sakshar/4-bit_PC/block.pdf

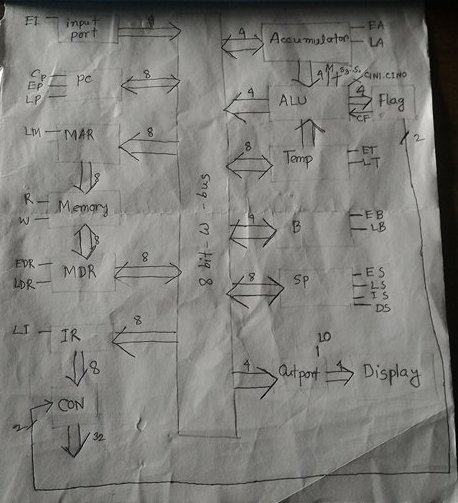
[picture p8: page 1]
