sakshar/4-bit_PC/SAP.xlsx

Macro-Instruction | Op-Code | Description | Total T-States | T-State | Micro-Operation | Active | HLT | AS1 | AS0 | LF_BAR | M | S3 | S2 | S1 | S0 | CIN1 | CIN0 | EF_BAR | EU_BAR | LS | IS | DS | ES_BAR | LT_BAR | ET_BAR | LO_BAR | EB_BAR | LB_BAR | EA_BAR | LA_BAR | EIN_BAR | LIR_BAR | MEM_BUS | LDR_BAR | EDR_BAR | EDB_BAR | W_BAR | R_BAR | LM_BAR | EM_BAR | CLEAR | CP | EP_BAR | LP | LOAD | RESET
ALL | - | Fetch | 4 | T1 | MAR ← PC | LM_BAR, EP_BAR, EM_BAR
 |  |  |  | T2 | PC← PC+1, MDR ← RAM[MAR] | CP, LDR_BAR, R_BAR, EM_BAR
 |  |  |  | T3 | IR ← MDR | EDB_BAR, LIR_BAR
 |  |  |  | T4 | LOAD from IR | LOAD
LDA address | 00H | ACC ← RAM[address] | 9 | T5 | MAR ← PC | LM_BAR, EP_BAR, EM_BAR
 |  |  |  | T6 | PC← PC+1, MDR ← RAM[MAR] | CP, LDR_BAR, R_BAR, EM_BAR
 |  |  |  | T7 | MAR ← MDR | LM_BAR, EDB_BAR, EM_BAR
 |  |  |  | T8 | MDR ← RAM[MAR] | LDR_BAR, R_BAR, EM_BAR
 |  |  |  | T9 | ACC ← MDR | LA_BAR, EDB_BAR, AS0, AS1, RESET
HALT | 0FH | Halts execution | 5 | T5 | HALT | HLT
IN | 02H | ACC ← input_port | 5 | T5 | ACC ← input_port | LA_BAR, AS0, AS1, EIN_BAR, RESET
STA address | 01H | RAM[address] ← ACC | 12 | T5 | MAR ← PC | LM_BAR, EP_BAR, EM_BAR
 |  |  |  | T6 | PC← PC+1, MDR ← RAM[MAR] | CP, LDR_BAR, R_BAR, EM_BAR
 |  |  |  | T7 | MAR ← MDR | LM_BAR, EDB_BAR, EM_BAR
 |  |  |  | T8 | MDR ← ACC | LDR_BAR, EA_BAR, MEM_BUS, EM_BAR
 |  |  |  | T9 | RAM[MAR] ← MDR | EDR_BAR, EM_BAR
 |  |  |  | T10 |  | W_BAR, EDR_BAR, EM_BAR
 |  |  |  | T11 |  | EDR_BAR, EM_BAR
 |  |  |  | T12 |  | R_BAR, RESET, EM_BAR
OUT | 03H | output_port ← ACC | 5 | T5 | output_port ← ACC | LO_BAR, EA_BAR, RESET
MOV B, ACC | 04H | B ← ACC | 5 | T5 | B ← ACC | LB_BAR, EA_BAR, RESET
MOV ACC, B | 05H | ACC ← B | 5 | T5 | ACC ← B | LA_BAR, AS0, AS1, EB_BAR, RESET
MOV ACC, immediate | 06H | ACC ← immediate | 7 | T5 | MAR ← PC | LM_BAR, EP_BAR, EM_BAR
 |  |  |  | T6 | PC← PC+1, MDR ← RAM[MAR] | CP, LDR_BAR, R_BAR, EM_BAR
 |  |  |  | T7 | ACC ← MDR | LA_BAR, AS0, AS1, EDB_BAR, RESET
NOP | 07H | NOP | 5 | T5 | NOP | RESET
JMP address | 08H | Jump to the address | 8 | T5 | MAR ← PC | LM_BAR, EP_BAR, EM_BAR
 |  |  |  | T6 | PC← PC+1, MDR ← RAM[MAR] | CP, LDR_BAR, R_BAR, EM_BAR
 |  |  |  | T7 | PC ← MDR | LP, EDB_BAR
 |  |  |  | T8 |  | CP, LP, RESET
ADD B | 09H | ACC ← ACC + B | 7 | T5 | TEMP ← B | LT_BAR, EB_BAR, S3, S0
 |  |  |  | T6 | ACC ← ACC + TEMP | S3, S0
 |  |  |  | T7 |  | LA_BAR, AS0, AS1, EU_BAR, S3, S0, LF_BAR, RESET
ADC B | 0AH | ACC ← ACC + B + C | 7 | T5 | TEMP ← B | LT_BAR, EB_BAR, S3, S0, CIN0
 |  |  |  | T6 | ACC ← ACC + TEMP + C | S3, S0, CIN0
 |  |  |  | T7 |  | LA_BAR, AS0, AS1, EU_BAR, S3, S0, CIN0, LF_BAR, RESET
SUB B | 0BH | ACC ← ACC - B | 7 | T5 | TEMP ← B | LT_BAR, EB_BAR, S2, S1, CIN1
 |  |  |  | T6 | ACC ← ACC - TEMP | S2, S1, CIN1
 |  |  |  | T7 |  | LA_BAR, AS0, AS1, EU_BAR, S2, S1, CIN1, LF_BAR, RESET
SBB B | 0CH | ACC ← ACC - B - BO | 7 | T5 | TEMP ← B | LT_BAR, EB_BAR, S2, S1, CIN1, CIN0
 |  |  |  | T6 | ACC ← ACC - TEMP - BO | S2, S1, CIN1, CIN0
 |  |  |  | T7 |  | LA_BAR, AS0, AS1, EU_BAR, S2, S1, CIN1, CIN0, LF_BAR, RESET
ADD immediate | 0DH | ACC ← ACC + immediate | 9 | T5 | MAR ← PC | LM_BAR, EP_BAR, EM_BAR
 |  |  |  | T6 | PC← PC+1, MDR ← RAM[MAR] | CP, LDR_BAR, R_BAR, EM_BAR
 |  |  |  | T7 | TEMP ← MDR | LT_BAR, EDB_BAR, S3, S0
 |  |  |  | T8 | ACC ← ACC + TEMP | S3, S0
 |  |  |  | T9 |  | LA_BAR, AS0, AS1, EU_BAR, S3, S0, LF_BAR, RESET
SUB [address] | 0EH | ACC ← ACC - RAM[address] | 11 | T5 | MAR ← PC | LM_BAR, EP_BAR, EM_BAR
 |  |  |  | T6 | PC← PC+1, MDR ← RAM[MAR] | CP, LDR_BAR, R_BAR, EM_BAR
 |  |  |  | T7 | MAR ← MDR | LM_BAR, EDB_BAR, EM_BAR
 |  |  |  | T8 | MDR ← RAM[MAR] | LDR_BAR, R_BAR, EM_BAR
 |  |  |  | T9 | TEMP ← MDR | LT_BAR, EDB_BAR, S2, S1, CIN1
 |  |  |  | T10 | ACC ← ACC - TEMP | S2, S1, CIN1
 |  |  |  | T11 |  | LA_BAR, AS0, AS1, EU_BAR, S2, S1, CIN1, LF_BAR, RESET
CMP B | 10H | ACC - B | 7 | T5 | TEMP ← B | LT_BAR, EB_BAR, S2, S1, CIN1
 |  |  |  | T6 | ACC - TEMP | S2, S1, CIN1
 |  |  |  | T7 |  | S2, S1, CIN1, LF_BAR, RESET
TEST B | 11H | ACC & B | 6 | T5 | TEMP ← B | LT_BAR, EB_BAR
 |  |  |  | T6 | ACC & TEMP | LF_BAR, M, S3, S2, S1, RESET
AND B | 12H | ACC ← ACC & B | 6 | T5 | TEMP ← B | LT_BAR, EB_BAR
 |  |  |  | T6 | ACC ← ACC & TEMP | LA_BAR, AS0, AS1, EU_BAR, M, S3, S2, S1, RESET
XOR immediate | 13H | ACC ← ACC ⊕ immediate | 8 | T5 | MAR ← PC | LM_BAR, EP_BAR, EM_BAR
 |  |  |  | T6 | PC← PC+1, MDR ← RAM[MAR] | CP, LDR_BAR, R_BAR, EM_BAR
 |  |  |  | T7 | TEMP ← MDR | LT_BAR, EDB_BAR
 |  |  |  | T8 | ACC ← ACC ⊕ TEMP | LA_BAR, AS0, AS1, EU_BAR, M, S3, S0, RESET
PUSH | 14H | RAM[SP] ← ACC | 10 | T5 | SP ← SP - 1, MDR ← ACC | DS, LDR_BAR, EA_BAR, MEM_BUS, EM_BAR
 |  |  |  | T6 | MAR ← SP | LM_BAR, ES_BAR, EM_BAR
 |  |  |  | T7 | RAM[MAR] ← MDR | EDR_BAR, EM_BAR
 |  |  |  | T8 |  | W_BAR, EDR_BAR, EM_BAR
 |  |  |  | T9 |  | EDR_BAR, EM_BAR
 |  |  |  | T10 |  | R_BAR, RESET, EM_BAR
POP | 15H | ACC ← RAM[SP] | 7 | T5 | MAR ← SP | LM_BAR, ES_BAR, EM_BAR
 |  |  |  | T6 | MDR ← RAM[MAR] | LDR_BAR, R_BAR, EM_BAR
 |  |  |  | T7 | ACC ← MDR, SP ← SP + 1 | LA_BAR, AS0, AS1, EDB_BAR, IS, RESET
CALL address | 16H | Calls a subroutine | 14 | T5 | MAR ← PC | LM_BAR, EP_BAR, EM_BAR
 |  |  |  | T6 | PC← PC+1, MDR ← RAM[MAR] | CP, LDR_BAR, R_BAR, EM_BAR
 |  |  |  | T7 | TEMP ← MDR, SP ← SP - 1 | LT_BAR, EDB_BAR, DS
 |  |  |  | T8 | MAR ← SP | LM_BAR, ES_BAR
 |  |  |  | T9 | MDR ← PC | LDR_BAR, EP_BAR, MEM_BUS
 |  |  |  | T10 | RAM[MAR] ← MDR | EDR_BAR, EM_BAR
 |  |  |  | T11 |  | W_BAR, EDR_BAR, EM_BAR
 |  |  |  | T12 |  | EDR_BAR, EM_BAR
 |  |  |  | T13 | PC ← TEMP | LP, ET_BAR
 |  |  |  | T14 |  | CP, LP, RESET
RET | 17H | Returns from current subroutine | 8 | T5 | MAR ← SP | LM_BAR, ES_BAR
 |  |  |  | T6 | MDR ← RAM[MAR] | LDR_BAR, R_BAR, EM_BAR
 |  |  |  | T7 | PC ← MDR, SP ← SP + 1 | LP, EDB_BAR, IS
 |  |  |  | T8 |  | CP, LP, RESET
SHL | 18H | ACC ← ACC << 1 | 6 | T5 | ACC ← ACC << 1 | EA_BAR
 |  |  |  | T6 |  | LA_BAR, AS0, RESET
SHR | 19H | ACC ← ACC >> 1 | 6 | T5 | ACC ← ACC >> 1 | EA_BAR
 |  |  |  | T6 |  | LA_BAR, AS1, RESET
JC address | 1AH | Jump if carry | 8 | T5 | MAR ← PC | LM_BAR, EP_BAR, EM_BAR
 |  |  |  | T6 | PC← PC+1, MDR ← RAM[MAR] | CP, LDR_BAR, R_BAR, EM_BAR
 |  |  |  | T7 | PC ← MDR | LP, EDB_BAR
 |  |  |  | T8 |  | CP, LP, RESET
JE address | 1BH | Jump if equal | 8 | T5 | MAR ← PC | LM_BAR, EP_BAR, EM_BAR
 |  |  |  | T6 | PC← PC+1, MDR ← RAM[MAR] | CP, LDR_BAR, R_BAR, EM_BAR
 |  |  |  | T7 | PC ← MDR | LP, EDB_BAR
 |  |  |  | T8 |  | CP, LP, RESET
