sakshar/4-bit_PC/Sap_MOTAMUTI_FINAL.xlsx

Sheet: BINARY
Macro-Instruction | Op-Code | Description | Total T-States | T-State | Micro-Operation | Active | HLT | AS1 | AS0 | LF_BAR | M | S3 | S2 | S1 | S0 | CIN1 | CIN0 | EF_BAR | EU_BAR | LS | IS | DS | ES_BAR | LT_BAR | ET_BAR | LO_BAR | EB_BAR | LB_BAR | EA_BAR | LA_BAR | EIN_BAR | LIR_BAR | MEM_BUS | LDR_BAR | EDR_BAR | EDB_BAR | W_BAR | R_BAR | LM_BAR | EM_BAR | CLEAR | CP | EP_BAR | LP | LOAD | RESET
ALL | - | Fetch | 4 | T1 | MAR ← PC | LM_BAR, EP_BAR, EM_BAR | 0 | 0 | 0 | 1 | 0 | 0 | 0 | 0 | 0 | 0 | 0 | 1 | 1 | 0 | 0 | 0 | 1 | 1 | 1 | 1 | 1 | 1 | 1 | 1 | 1 | 1 | 0 | 1 | 1 | 1 | 1 | 1 | 0 | 0 | 0 | 0 | 0 | 0 | 0 | 0
 |  |  |  | T2 | PC← PC+1, MDR ← RAM[MAR] | CP, LDR_BAR, R_BAR, EM_BAR | 0 | 0 | 0 | 1 | 0 | 0 | 0 | 0 | 0 | 0 | 0 | 1 | 1 | 0 | 0 | 0 | 1 | 1 | 1 | 1 | 1 | 1 | 1 | 1 | 1 | 1 | 0 | 0 | 1 | 1 | 1 | 0 | 1 | 0 | 0 | 1 | 1 | 0 | 0 | 0
 |  |  |  | T3 | IR ← MDR | EDB_BAR, LIR_BAR | 0 | 0 | 0 | 1 | 0 | 0 | 0 | 0 | 0 | 0 | 0 | 1 | 1 | 0 | 0 | 0 | 1 | 1 | 1 | 1 | 1 | 1 | 1 | 1 | 1 | 0 | 0 | 1 | 1 | 0 | 1 | 1 | 1 | 1 | 0 | 0 | 1 | 0 | 0 | 0
 |  |  |  | T4 | LOAD from IR | LOAD | 0 | 0 | 0 | 1 | 0 | 0 | 0 | 0 | 0 | 0 | 0 | 1 | 1 | 0 | 0 | 0 | 1 | 1 | 1 | 1 | 1 | 1 | 1 | 1 | 1 | 1 | 0 | 1 | 1 | 1 | 1 | 1 | 1 | 1 | 0 | 0 | 1 | 0 | 1 | 0
LDA address | 00H | ACC ← RAM[address] | 9 | T5 | MAR ← PC | LM_BAR, EP_BAR, EM_BAR | 0 | 0 | 0 | 1 | 0 | 0 | 0 | 0 | 0 | 0 | 0 | 1 | 1 | 0 | 0 | 0 | 1 | 1 | 1 | 1 | 1 | 1 | 1 | 1 | 1 | 1 | 0 | 1 | 1 | 1 | 1 | 1 | 0 | 0 | 0 | 0 | 0 | 0 | 0 | 0
 |  |  |  | T6 | PC← PC+1, MDR ← RAM[MAR] | CP, LDR_BAR, R_BAR, EM_BAR | 0 | 0 | 0 | 1 | 0 | 0 | 0 | 0 | 0 | 0 | 0 | 1 | 1 | 0 | 0 | 0 | 1 | 1 | 1 | 1 | 1 | 1 | 1 | 1 | 1 | 1 | 0 | 0 | 1 | 1 | 1 | 0 | 1 | 0 | 0 | 1 | 1 | 0 | 0 | 0
 |  |  |  | T7 | MAR ← MDR | LM_BAR, EDB_BAR, EM_BAR | 0 | 0 | 0 | 1 | 0 | 0 | 0 | 0 | 0 | 0 | 0 | 1 | 1 | 0 | 0 | 0 | 1 | 1 | 1 | 1 | 1 | 1 | 1 | 1 | 1 | 1 | 0 | 1 | 1 | 0 | 1 | 1 | 0 | 0 | 0 | 0 | 1 | 0 | 0 | 0
 |  |  |  | T8 | MDR ← RAM[MAR] | LDR_BAR, R_BAR, EM_BAR | 0 | 0 | 0 | 1 | 0 | 0 | 0 | 0 | 0 | 0 | 0 | 1 | 1 | 0 | 0 | 0 | 1 | 1 | 1 | 1 | 1 | 1 | 1 | 1 | 1 | 1 | 0 | 0 | 1 | 1 | 1 | 0 | 1 | 0 | 0 | 0 | 1 | 0 | 0 | 0
 |  |  |  | T9 | ACC ← MDR | LA_BAR, EDB_BAR, AS0, AS1, RESET | 0 | 1 | 1 | 1 | 0 | 0 | 0 | 0 | 0 | 0 | 0 | 1 | 1 | 0 | 0 | 0 | 1 | 1 | 1 | 1 | 1 | 1 | 1 | 0 | 1 | 1 | 0 | 1 | 1 | 0 | 1 | 1 | 1 | 1 | 0 | 0 | 1 | 0 | 0 | 1
HALT | 0FH | Halts execution | 5 | T5 | HALT | HLT | 1 | 0 | 0 | 1 | 0 | 0 | 0 | 0 | 0 | 0 | 0 | 1 | 1 | 0 | 0 | 0 | 1 | 1 | 1 | 1 | 1 | 1 | 1 | 1 | 1 | 1 | 0 | 1 | 1 | 1 | 1 | 1 | 1 | 1 | 0 | 0 | 1 | 0 | 0 | 0
IN | 02H | ACC ← input_port | 5 | T5 | ACC ← input_port | LA_BAR, AS0, AS1, EIN_BAR, RESET | 0 | 1 | 1 | 1 | 0 | 0 | 0 | 0 | 0 | 0 | 0 | 1 | 1 | 0 | 0 | 0 | 1 | 1 | 1 | 1 | 1 | 1 | 1 | 0 | 0 | 1 | 0 | 1 | 1 | 1 | 1 | 1 | 1 | 1 | 0 | 0 | 1 | 0 | 0 | 1
STA address | 01H | RAM[address] ← ACC | 12 | T5 | MAR ← PC | LM_BAR, EP_BAR, EM_BAR | 0 | 0 | 0 | 1 | 0 | 0 | 0 | 0 | 0 | 0 | 0 | 1 | 1 | 0 | 0 | 0 | 1 | 1 | 1 | 1 | 1 | 1 | 1 | 1 | 1 | 1 | 0 | 1 | 1 | 1 | 1 | 1 | 0 | 0 | 0 | 0 | 0 | 0 | 0 | 0
 |  |  |  | T6 | PC← PC+1, MDR ← RAM[MAR] | CP, LDR_BAR, R_BAR, EM_BAR | 0 | 0 | 0 | 1 | 0 | 0 | 0 | 0 | 0 | 0 | 0 | 1 | 1 | 0 | 0 | 0 | 1 | 1 | 1 | 1 | 1 | 1 | 1 | 1 | 1 | 1 | 0 | 0 | 1 | 1 | 1 | 0 | 1 | 0 | 0 | 1 | 1 | 0 | 0 | 0
 |  |  |  | T7 | MAR ← MDR | LM_BAR, EDB_BAR, EM_BAR | 0 | 0 | 0 | 1 | 0 | 0 | 0 | 0 | 0 | 0 | 0 | 1 | 1 | 0 | 0 | 0 | 1 | 1 | 1 | 1 | 1 | 1 | 1 | 1 | 1 | 1 | 0 | 1 | 1 | 0 | 1 | 1 | 0 | 0 | 0 | 0 | 1 | 0 | 0 | 0
 |  |  |  | T8 | MDR ← ACC | LDR_BAR, EA_BAR, MEM_BUS, EM_BAR | 0 | 0 | 0 | 1 | 0 | 0 | 0 | 0 | 0 | 0 | 0 | 1 | 1 | 0 | 0 | 0 | 1 | 1 | 1 | 1 | 1 | 1 | 0 | 1 | 1 | 1 | 1 | 0 | 1 | 1 | 1 | 1 | 1 | 0 | 0 | 0 | 1 | 0 | 0 | 0
 |  |  |  | T9 | RAM[MAR] ← MDR | EDR_BAR, EM_BAR | 0 | 0 | 0 | 1 | 0 | 0 | 0 | 0 | 0 | 0 | 0 | 1 | 1 | 0 | 0 | 0 | 1 | 1 | 1 | 1 | 1 | 1 | 1 | 1 | 1 | 1 | 0 | 1 | 0 | 1 | 1 | 1 | 1 | 0 | 0 | 0 | 1 | 0 | 0 | 0
 |  |  |  | T10 |  | W_BAR, EDR_BAR, EM_BAR | 0 | 0 | 0 | 1 | 0 | 0 | 0 | 0 | 0 | 0 | 0 | 1 | 1 | 0 | 0 | 0 | 1 | 1 | 1 | 1 | 1 | 1 | 1 | 1 | 1 | 1 | 0 | 1 | 0 | 1 | 0 | 1 | 1 | 0 | 0 | 0 | 1 | 0 | 0 | 0
 |  |  |  | T11 |  | EDR_BAR, EM_BAR | 0 | 0 | 0 | 1 | 0 | 0 | 0 | 0 | 0 | 0 | 0 | 1 | 1 | 0 | 0 | 0 | 1 | 1 | 1 | 1 | 1 | 1 | 1 | 1 | 1 | 1 | 0 | 1 | 0 | 1 | 1 | 1 | 1 | 0 | 0 | 0 | 1 | 0 | 0 | 0
 |  |  |  | T12 |  | R_BAR, RESET, EM_BAR | 0 | 0 | 0 | 1 | 0 | 0 | 0 | 0 | 0 | 0 | 0 | 1 | 1 | 0 | 0 | 0 | 1 | 1 | 1 | 1 | 1 | 1 | 1 | 1 | 1 | 1 | 0 | 1 | 1 | 1 | 1 | 0 | 1 | 0 | 0 | 0 | 1 | 0 | 0 | 1
OUT | 03H | output_port ← ACC | 5 | T5 | output_port ← ACC | LO_BAR, EA_BAR, RESET | 0 | 0 | 0 | 1 | 0 | 0 | 0 | 0 | 0 | 0 | 0 | 1 | 1 | 0 | 0 | 0 | 1 | 1 | 1 | 0 | 1 | 1 | 0 | 1 | 1 | 1 | 0 | 1 | 1 | 1 | 1 | 1 | 1 | 1 | 0 | 0 | 1 | 0 | 0 | 1
MOV B, ACC | 04H | B ← ACC | 5 | T5 | B ← ACC | LB_BAR, EA_BAR, RESET | 0 | 0 | 0 | 1 | 0 | 0 | 0 | 0 | 0 | 0 | 0 | 1 | 1 | 0 | 0 | 0 | 1 | 1 | 1 | 1 | 1 | 0 | 0 | 1 | 1 | 1 | 0 | 1 | 1 | 1 | 1 | 1 | 1 | 1 | 0 | 0 | 1 | 0 | 0 | 1
MOV ACC, B | 05H | ACC ← B | 5 | T5 | ACC ← B | LA_BAR, AS0, AS1, EB_BAR, RESET | 0 | 1 | 1 | 1 | 0 | 0 | 0 | 0 | 0 | 0 | 0 | 1 | 1 | 0 | 0 | 0 | 1 | 1 | 1 | 1 | 0 | 1 | 1 | 0 | 1 | 1 | 0 | 1 | 1 | 1 | 1 | 1 | 1 | 1 | 0 | 0 | 1 | 0 | 0 | 1
MOV ACC, immediate | 06H | ACC ← immediate | 7 | T5 | MAR ← PC | LM_BAR, EP_BAR, EM_BAR | 0 | 0 | 0 | 1 | 0 | 0 | 0 | 0 | 0 | 0 | 0 | 1 | 1 | 0 | 0 | 0 | 1 | 1 | 1 | 1 | 1 | 1 | 1 | 1 | 1 | 1 | 0 | 1 | 1 | 1 | 1 | 1 | 0 | 0 | 0 | 0 | 0 | 0 | 0 | 0
 |  |  |  | T6 | PC← PC+1, MDR ← RAM[MAR] | CP, LDR_BAR, R_BAR, EM_BAR | 0 | 0 | 0 | 1 | 0 | 0 | 0 | 0 | 0 | 0 | 0 | 1 | 1 | 0 | 0 | 0 | 1 | 1 | 1 | 1 | 1 | 1 | 1 | 1 | 1 | 1 | 0 | 0 | 1 | 1 | 1 | 0 | 1 | 0 | 0 | 1 | 1 | 0 | 0 | 0
 |  |  |  | T7 | ACC ← MDR | LA_BAR, AS0, AS1, EDB_BAR, RESET | 0 | 1 | 1 | 1 | 0 | 0 | 0 | 0 | 0 | 0 | 0 | 1 | 1 | 0 | 0 | 0 | 1 | 1 | 1 | 1 | 1 | 1 | 1 | 0 | 1 | 1 | 0 | 1 | 1 | 0 | 1 | 1 | 1 | 1 | 0 | 0 | 1 | 0 | 0 | 1
NOP | 07H | NOP | 5 | T5 | NOP | RESET | 0 | 0 | 0 | 1 | 0 | 0 | 0 | 0 | 0 | 0 | 0 | 1 | 1 | 0 | 0 | 0 | 1 | 1 | 1 | 1 | 1 | 1 | 1 | 1 | 1 | 1 | 0 | 1 | 1 | 1 | 1 | 1 | 1 | 1 | 0 | 0 | 1 | 0 | 0 | 1
JMP address | 08H | Jump to the address | 8 | T5 | MAR ← PC | LM_BAR, EP_BAR, EM_BAR | 0 | 0 | 0 | 1 | 0 | 0 | 0 | 0 | 0 | 0 | 0 | 1 | 1 | 0 | 0 | 0 | 1 | 1 | 1 | 1 | 1 | 1 | 1 | 1 | 1 | 1 | 0 | 1 | 1 | 1 | 1 | 1 | 0 | 0 | 0 | 0 | 0 | 0 | 0 | 0
 |  |  |  | T6 | PC← PC+1, MDR ← RAM[MAR] | CP, LDR_BAR, R_BAR, EM_BAR | 0 | 0 | 0 | 1 | 0 | 0 | 0 | 0 | 0 | 0 | 0 | 1 | 1 | 0 | 0 | 0 | 1 | 1 | 1 | 1 | 1 | 1 | 1 | 1 | 1 | 1 | 0 | 0 | 1 | 1 | 1 | 0 | 1 | 0 | 0 | 1 | 1 | 0 | 0 | 0
 |  |  |  | T7 | PC ← MDR | LP, EDB_BAR | 0 | 0 | 0 | 1 | 0 | 0 | 0 | 0 | 0 | 0 | 0 | 1 | 1 | 0 | 0 | 0 | 1 | 1 | 1 | 1 | 1 | 1 | 1 | 1 | 1 | 1 | 0 | 1 | 1 | 0 | 1 | 1 | 1 | 1 | 0 | 0 | 1 | 1 | 0 | 0
 |  |  |  | T8 |  | CP, LP, RESET | 0 | 0 | 0 | 1 | 0 | 0 | 0 | 0 | 0 | 0 | 0 | 1 | 1 | 0 | 0 | 0 | 1 | 1 | 1 | 1 | 1 | 1 | 1 | 1 | 1 | 1 | 0 | 1 | 1 | 1 | 1 | 1 | 1 | 1 | 0 | 1 | 1 | 1 | 0 | 1
ADD B | 09H | ACC ← ACC + B | 7 | T5 | TEMP ← B | LT_BAR, EB_BAR, S3, S0 | 0 | 0 | 0 | 1 | 0 | 1 | 0 | 0 | 1 | 0 | 0 | 1 | 1 | 0 | 0 | 0 | 1 | 0 | 1 | 1 | 0 | 1 | 1 | 1 | 1 | 1 | 0 | 1 | 1 | 1 | 1 | 1 | 1 | 1 | 0 | 0 | 1 | 0 | 0 | 0
 |  |  |  | T6 | ACC ← ACC + TEMP | S3, S0 | 0 | 0 | 0 | 1 | 0 | 1 | 0 | 0 | 1 | 0 | 0 | 1 | 1 | 0 | 0 | 0 | 1 | 1 | 1 | 1 | 1 | 1 | 1 | 1 | 1 | 1 | 0 | 1 | 1 | 1 | 1 | 1 | 1 | 1 | 0 | 0 | 1 | 0 | 0 | 0
 |  |  |  | T7 |  | LA_BAR, AS0, AS1, EU_BAR, S3, S0, LF_BAR, RESET | 0 | 1 | 1 | 0 | 0 | 1 | 0 | 0 | 1 | 0 | 0 | 1 | 0 | 0 | 0 | 0 | 1 | 1 | 1 | 1 | 1 | 1 | 1 | 0 | 1 | 1 | 0 | 1 | 1 | 1 | 1 | 1 | 1 | 1 | 0 | 0 | 1 | 0 | 0 | 1
ADC B | 0AH | ACC ← ACC + B + C | 7 | T5 | TEMP ← B | LT_BAR, EB_BAR, S3, S0, CIN0 | 0 | 0 | 0 | 1 | 0 | 1 | 0 | 0 | 1 | 0 | 1 | 1 | 1 | 0 | 0 | 0 | 1 | 0 | 1 | 1 | 0 | 1 | 1 | 1 | 1 | 1 | 0 | 1 | 1 | 1 | 1 | 1 | 1 | 1 | 0 | 0 | 1 | 0 | 0 | 0
 |  |  |  | T6 | ACC ← ACC + TEMP + C | S3, S0, CIN0 | 0 | 0 | 0 | 1 | 0 | 1 | 0 | 0 | 1 | 0 | 1 | 1 | 1 | 0 | 0 | 0 | 1 | 1 | 1 | 1 | 1 | 1 | 1 | 1 | 1 | 1 | 0 | 1 | 1 | 1 | 1 | 1 | 1 | 1 | 0 | 0 | 1 | 0 | 0 | 0
 |  |  |  | T7 |  | LA_BAR, AS0, AS1, EU_BAR, S3, S0, CIN0, LF_BAR, RESET | 0 | 1 | 1 | 0 | 0 | 1 | 0 | 0 | 1 | 0 | 1 | 1 | 0 | 0 | 0 | 0 | 1 | 1 | 1 | 1 | 1 | 1 | 1 | 0 | 1 | 1 | 0 | 1 | 1 | 1 | 1 | 1 | 1 | 1 | 0 | 0 | 1 | 0 | 0 | 1
SUB B | 0BH | ACC ← ACC - B | 7 | T5 | TEMP ← B | LT_BAR, EB_BAR, S2, S1, CIN1 | 0 | 0 | 0 | 1 | 0 | 0 | 1 | 1 | 0 | 1 | 0 | 1 | 1 | 0 | 0 | 0 | 1 | 0 | 1 | 1 | 0 | 1 | 1 | 1 | 1 | 1 | 0 | 1 | 1 | 1 | 1 | 1 | 1 | 1 | 0 | 0 | 1 | 0 | 0 | 0
 |  |  |  | T6 | ACC ← ACC - TEMP | S2, S1, CIN1 | 0 | 0 | 0 | 1 | 0 | 0 | 1 | 1 | 0 | 1 | 0 | 1 | 1 | 0 | 0 | 0 | 1 | 1 | 1 | 1 | 1 | 1 | 1 | 1 | 1 | 1 | 0 | 1 | 1 | 1 | 1 | 1 | 1 | 1 | 0 | 0 | 1 | 0 | 0 | 0
 |  |  |  | T7 |  | LA_BAR, AS0, AS1, EU_BAR, S2, S1, CIN1, LF_BAR, RESET | 0 | 1 | 1 | 0 | 0 | 0 | 1 | 1 | 0 | 1 | 0 | 1 | 0 | 0 | 0 | 0 | 1 | 1 | 1 | 1 | 1 | 1 | 1 | 0 | 1 | 1 | 0 | 1 | 1 | 1 | 1 | 1 | 1 | 1 | 0 | 0 | 1 | 0 | 0 | 1
SBB B | 0CH | ACC ← ACC - B - BO | 7 | T5 | TEMP ← B | LT_BAR, EB_BAR, S2, S1, CIN1, CIN0 | 0 | 0 | 0 | 1 | 0 | 0 | 1 | 1 | 0 | 1 | 1 | 1 | 1 | 0 | 0 | 0 | 1 | 0 | 1 | 1 | 0 | 1 | 1 | 1 | 1 | 1 | 0 | 1 | 1 | 1 | 1 | 1 | 1 | 1 | 0 | 0 | 1 | 0 | 0 | 0
 |  |  |  | T6 | ACC ← ACC - TEMP - BO | S2, S1, CIN1, CIN0 | 0 | 0 | 0 | 1 | 0 | 0 | 1 | 1 | 0 | 1 | 1 | 1 | 1 | 0 | 0 | 0 | 1 | 1 | 1 | 1 | 1 | 1 | 1 | 1 | 1 | 1 | 0 | 1 | 1 | 1 | 1 | 1 | 1 | 1 | 0 | 0 | 1 | 0 | 0 | 0
 |  |  |  | T7 |  | LA_BAR, AS0, AS1, EU_BAR, S2, S1, CIN1, CIN0, LF_BAR, RESET | 0 | 1 | 1 | 0 | 0 | 0 | 1 | 1 | 0 | 1 | 1 | 1 | 0 | 0 | 0 | 0 | 1 | 1 | 1 | 1 | 1 | 1 | 1 | 0 | 1 | 1 | 0 | 1 | 1 | 1 | 1 | 1 | 1 | 1 | 0 | 0 | 1 | 0 | 0 | 1
ADD immediate | 0DH | ACC ← ACC + immediate | 9 | T5 | MAR ← PC | LM_BAR, EP_BAR, EM_BAR | 0 | 0 | 0 | 1 | 0 | 0 | 0 | 0 | 0 | 0 | 0 | 1 | 1 | 0 | 0 | 0 | 1 | 1 | 1 | 1 | 1 | 1 | 1 | 1 | 1 | 1 | 0 | 1 | 1 | 1 | 1 | 1 | 0 | 0 | 0 | 0 | 0 | 0 | 0 | 0
 |  |  |  | T6 | PC← PC+1, MDR ← RAM[MAR] | CP, LDR_BAR, R_BAR, EM_BAR | 0 | 0 | 0 | 1 | 0 | 0 | 0 | 0 | 0 | 0 | 0 | 1 | 1 | 0 | 0 | 0 | 1 | 1 | 1 | 1 | 1 | 1 | 1 | 1 | 1 | 1 | 0 | 0 | 1 | 1 | 1 | 0 | 1 | 0 | 0 | 1 | 1 | 0 | 0 | 0
 |  |  |  | T7 | TEMP ← MDR | LT_BAR, EDB_BAR, S3, S0 | 0 | 0 | 0 | 1 | 0 | 1 | 0 | 0 | 1 | 0 | 0 | 1 | 1 | 0 | 0 | 0 | 1 | 0 | 1 | 1 | 1 | 1 | 1 | 1 | 1 | 1 | 0 | 1 | 1 | 0 | 1 | 1 | 1 | 1 | 0 | 0 | 1 | 0 | 0 | 0
 |  |  |  | T8 | ACC ← ACC + TEMP | S3, S0 | 0 | 0 | 0 | 1 | 0 | 1 | 0 | 0 | 1 | 0 | 0 | 1 | 1 | 0 | 0 | 0 | 1 | 1 | 1 | 1 | 1 | 1 | 1 | 1 | 1 | 1 | 0 | 1 | 1 | 1 | 1 | 1 | 1 | 1 | 0 | 0 | 1 | 0 | 0 | 0
 |  |  |  | T9 |  | LA_BAR, AS0, AS1, EU_BAR, S3, S0, LF_BAR, RESET | 0 | 1 | 1 | 0 | 0 | 1 | 0 | 0 | 1 | 0 | 0 | 1 | 0 | 0 | 0 | 0 | 1 | 1 | 1 | 1 | 1 | 1 | 1 | 0 | 1 | 1 | 0 | 1 | 1 | 1 | 1 | 1 | 1 | 1 | 0 | 0 | 1 | 0 | 0 | 1
SUB [address] | 0EH | ACC ← ACC - RAM[address] | 11 | T5 | MAR ← PC | LM_BAR, EP_BAR, EM_BAR | 0 | 0 | 0 | 1 | 0 | 0 | 0 | 0 | 0 | 0 | 0 | 1 | 1 | 0 | 0 | 0 | 1 | 1 | 1 | 1 | 1 | 1 | 1 | 1 | 1 | 1 | 0 | 1 | 1 | 1 | 1 | 1 | 0 | 0 | 0 | 0 | 0 | 0 | 0 | 0
 |  |  |  | T6 | PC← PC+1, MDR ← RAM[MAR] | CP, LDR_BAR, R_BAR, EM_BAR | 0 | 0 | 0 | 1 | 0 | 0 | 0 | 0 | 0 | 0 | 0 | 1 | 1 | 0 | 0 | 0 | 1 | 1 | 1 | 1 | 1 | 1 | 1 | 1 | 1 | 1 | 0 | 0 | 1 | 1 | 1 | 0 | 1 | 0 | 0 | 1 | 1 | 0 | 0 | 0
 |  |  |  | T7 | MAR ← MDR | LM_BAR, EDB_BAR, EM_BAR | 0 | 0 | 0 | 1 | 0 | 0 | 0 | 0 | 0 | 0 | 0 | 1 | 1 | 0 | 0 | 0 | 1 | 1 | 1 | 1 | 1 | 1 | 1 | 1 | 1 | 1 | 0 | 1 | 1 | 0 | 1 | 1 | 0 | 0 | 0 | 0 | 1 | 0 | 0 | 0
 |  |  |  | T8 | MDR ← RAM[MAR] | LDR_BAR, R_BAR, EM_BAR | 0 | 0 | 0 | 1 | 0 | 0 | 0 | 0 | 0 | 0 | 0 | 1 | 1 | 0 | 0 | 0 | 1 | 1 | 1 | 1 | 1 | 1 | 1 | 1 | 1 | 1 | 0 | 0 | 1 | 1 | 1 | 0 | 1 | 0 | 0 | 0 | 1 | 0 | 0 | 0
 |  |  |  | T9 | TEMP ← MDR | LT_BAR, EDB_BAR, S2, S1, CIN1 | 0 | 0 | 0 | 1 | 0 | 0 | 1 | 1 | 0 | 1 | 0 | 1 | 1 | 0 | 0 | 0 | 1 | 0 | 1 | 1 | 1 | 1 | 1 | 1 | 1 | 1 | 0 | 1 | 1 | 0 | 1 | 1 | 1 | 1 | 0 | 0 | 1 | 0 | 0 | 0
 |  |  |  | T10 | ACC ← ACC - TEMP | S2, S1, CIN1 | 0 | 0 | 0 | 1 | 0 | 0 | 1 | 1 | 0 | 1 | 0 | 1 | 1 | 0 | 0 | 0 | 1 | 1 | 1 | 1 | 1 | 1 | 1 | 1 | 1 | 1 | 0 | 1 | 1 | 1 | 1 | 1 | 1 | 1 | 0 | 0 | 1 | 0 | 0 | 0
 |  |  |  | T11 |  | LA_BAR, AS0, AS1, EU_BAR, S2, S1, CIN1, LF_BAR, RESET | 0 | 1 | 1 | 0 | 0 | 0 | 1 | 1 | 0 | 1 | 0 | 1 | 0 | 0 | 0 | 0 | 1 | 1 | 1 | 1 | 1 | 1 | 1 | 0 | 1 | 1 | 0 | 1 | 1 | 1 | 1 | 1 | 1 | 1 | 0 | 0 | 1 | 0 | 0 | 1
CMP B | 10H | ACC - B | 7 | T5 | TEMP ← B | LT_BAR, EB_BAR, S2, S1, CIN1 | 0 | 0 | 0 | 1 | 0 | 0 | 1 | 1 | 0 | 1 | 0 | 1 | 1 | 0 | 0 | 0 | 1 | 0 | 1 | 1 | 0 | 1 | 1 | 1 | 1 | 1 | 0 | 1 | 1 | 1 | 1 | 1 | 1 | 1 | 0 | 0 | 1 | 0 | 0 | 0
 |  |  |  | T6 | ACC - TEMP | S2, S1, CIN1 | 0 | 0 | 0 | 1 | 0 | 0 | 1 | 1 | 0 | 1 | 0 | 1 | 1 | 0 | 0 | 0 | 1 | 1 | 1 | 1 | 1 | 1 | 1 | 1 | 1 | 1 | 0 | 1 | 1 | 1 | 1 | 1 | 1 | 1 | 0 | 0 | 1 | 0 | 0 | 0
 |  |  |  | T7 |  | S2, S1, CIN1, LF_BAR, RESET | 0 | 0 | 0 | 0 | 0 | 0 | 1 | 1 | 0 | 1 | 0 | 1 | 1 | 0 | 0 | 0 | 1 | 1 | 1 | 1 | 1 | 1 | 1 | 1 | 1 | 1 | 0 | 1 | 1 | 1 | 1 | 1 | 1 | 1 | 0 | 0 | 1 | 0 | 0 | 1
TEST B | 11H | ACC & B | 6 | T5 | TEMP ← B | LT_BAR, EB_BAR | 0 | 0 | 0 | 1 | 0 | 0 | 0 | 0 | 0 | 0 | 0 | 1 | 1 | 0 | 0 | 0 | 1 | 0 | 1 | 1 | 0 | 1 | 1 | 1 | 1 | 1 | 0 | 1 | 1 | 1 | 1 | 1 | 1 | 1 | 0 | 0 | 1 | 0 | 0 | 0
 |  |  |  | T6 | ACC & TEMP | LF_BAR, M, S3, S2, S1, RESET | 0 | 0 | 0 | 0 | 1 | 1 | 1 | 1 | 0 | 0 | 0 | 1 | 1 | 0 | 0 | 0 | 1 | 1 | 1 | 1 | 1 | 1 | 1 | 1 | 1 | 1 | 0 | 1 | 1 | 1 | 1 | 1 | 1 | 1 | 0 | 0 | 1 | 0 | 0 | 1
AND B | 12H | ACC ← ACC & B | 6 | T5 | TEMP ← B | LT_BAR, EB_BAR | 0 | 0 | 0 | 1 | 0 | 0 | 0 | 0 | 0 | 0 | 0 | 1 | 1 | 0 | 0 | 0 | 1 | 0 | 1 | 1 | 0 | 1 | 1 | 1 | 1 | 1 | 0 | 1 | 1 | 1 | 1 | 1 | 1 | 1 | 0 | 0 | 1 | 0 | 0 | 0
 |  |  |  | T6 | ACC ← ACC & TEMP | LA_BAR, AS0, AS1, EU_BAR, M, S3, S2, S1, RESET | 0 | 1 | 1 | 1 | 1 | 1 | 1 | 1 | 0 | 0 | 0 | 1 | 0 | 0 | 0 | 0 | 1 | 1 | 1 | 1 | 1 | 1 | 1 | 0 | 1 | 1 | 0 | 1 | 1 | 1 | 1 | 1 | 1 | 1 | 0 | 0 | 1 | 0 | 0 | 1
XOR immediate | 13H | ACC ← ACC ⊕ immediate | 8 | T5 | MAR ← PC | LM_BAR, EP_BAR, EM_BAR | 0 | 0 | 0 | 1 | 0 | 0 | 0 | 0 | 0 | 0 | 0 | 1 | 1 | 0 | 0 | 0 | 1 | 1 | 1 | 1 | 1 | 1 | 1 | 1 | 1 | 1 | 0 | 1 | 1 | 1 | 1 | 1 | 0 | 0 | 0 | 0 | 0 | 0 | 0 | 0
 |  |  |  | T6 | PC← PC+1, MDR ← RAM[MAR] | CP, LDR_BAR, R_BAR, EM_BAR | 0 | 0 | 0 | 1 | 0 | 0 | 0 | 0 | 0 | 0 | 0 | 1 | 1 | 0 | 0 | 0 | 1 | 1 | 1 | 1 | 1 | 1 | 1 | 1 | 1 | 1 | 0 | 0 | 1 | 1 | 1 | 0 | 1 | 0 | 0 | 1 | 1 | 0 | 0 | 0
 |  |  |  | T7 | TEMP ← MDR | LT_BAR, EDB_BAR | 0 | 0 | 0 | 1 | 0 | 0 | 0 | 0 | 0 | 0 | 0 | 1 | 1 | 0 | 0 | 0 | 1 | 0 | 1 | 1 | 1 | 1 | 1 | 1 | 1 | 1 | 0 | 1 | 1 | 0 | 1 | 1 | 1 | 1 | 0 | 0 | 1 | 0 | 0 | 0
 |  |  |  | T8 | ACC ← ACC ⊕ TEMP | LA_BAR, AS0, AS1, EU_BAR, M, S3, S0, RESET | 0 | 1 | 1 | 1 | 1 | 1 | 0 | 0 | 1 | 0 | 0 | 1 | 0 | 0 | 0 | 0 | 1 | 1 | 1 | 1 | 1 | 1 | 1 | 0 | 1 | 1 | 0 | 1 | 1 | 1 | 1 | 1 | 1 | 1 | 0 | 0 | 1 | 0 | 0 | 1
PUSH | 14H | RAM[SP] ← ACC | 10 | T5 | SP ← SP - 1, MDR ← ACC | DS, LDR_BAR, EA_BAR, MEM_BUS, EM_BAR | 0 | 0 | 0 | 1 | 0 | 0 | 0 | 0 | 0 | 0 | 0 | 1 | 1 | 0 | 0 | 1 | 1 | 1 | 1 | 1 | 1 | 1 | 0 | 1 | 1 | 1 | 1 | 0 | 1 | 1 | 1 | 1 | 1 | 0 | 0 | 0 | 1 | 0 | 0 | 0
 |  |  |  | T6 | MAR ← SP | LM_BAR, ES_BAR, EM_BAR | 0 | 0 | 0 | 1 | 0 | 0 | 0 | 0 | 0 | 0 | 0 | 1 | 1 | 0 | 0 | 0 | 0 | 1 | 1 | 1 | 1 | 1 | 1 | 1 | 1 | 1 | 0 | 1 | 1 | 1 | 1 | 1 | 0 | 0 | 0 | 0 | 1 | 0 | 0 | 0
 |  |  |  | T7 | RAM[MAR] ← MDR | EDR_BAR, EM_BAR | 0 | 0 | 0 | 1 | 0 | 0 | 0 | 0 | 0 | 0 | 0 | 1 | 1 | 0 | 0 | 0 | 1 | 1 | 1 | 1 | 1 | 1 | 1 | 1 | 1 | 1 | 0 | 1 | 0 | 1 | 1 | 1 | 1 | 0 | 0 | 0 | 1 | 0 | 0 | 0
 |  |  |  | T8 |  | W_BAR, EDR_BAR, EM_BAR | 0 | 0 | 0 | 1 | 0 | 0 | 0 | 0 | 0 | 0 | 0 | 1 | 1 | 0 | 0 | 0 | 1 | 1 | 1 | 1 | 1 | 1 | 1 | 1 | 1 | 1 | 0 | 1 | 0 | 1 | 0 | 1 | 1 | 0 | 0 | 0 | 1 | 0 | 0 | 0
 |  |  |  | T9 |  | EDR_BAR, EM_BAR | 0 | 0 | 0 | 1 | 0 | 0 | 0 | 0 | 0 | 0 | 0 | 1 | 1 | 0 | 0 | 0 | 1 | 1 | 1 | 1 | 1 | 1 | 1 | 1 | 1 | 1 | 0 | 1 | 0 | 1 | 1 | 1 | 1 | 0 | 0 | 0 | 1 | 0 | 0 | 0
 |  |  |  | T10 |  | R_BAR, RESET, EM_BAR | 0 | 0 | 0 | 1 | 0 | 0 | 0 | 0 | 0 | 0 | 0 | 1 | 1 | 0 | 0 | 0 | 1 | 1 | 1 | 1 | 1 | 1 | 1 | 1 | 1 | 1 | 0 | 1 | 1 | 1 | 1 | 0 | 1 | 0 | 0 | 0 | 1 | 0 | 0 | 1
POP | 15H | ACC ← RAM[SP] |  | T5 | MAR ← SP | LM_BAR, ES_BAR, EM_BAR | 0 | 0 | 0 | 1 | 0 | 0 | 0 | 0 | 0 | 0 | 0 | 1 | 1 | 0 | 0 | 0 | 0 | 1 | 1 | 1 | 1 | 1 | 1 | 1 | 1 | 1 | 0 | 1 | 1 | 1 | 1 | 1 | 0 | 0 | 0 | 0 | 1 | 0 | 0 | 0
 |  |  |  | T6 | MDR ← RAM[MAR] | LDR_BAR, R_BAR, EM_BAR | 0 | 0 | 0 | 1 | 0 | 0 | 0 | 0 | 0 | 0 | 0 | 1 | 1 | 0 | 0 | 0 | 1 | 1 | 1 | 1 | 1 | 1 | 1 | 1 | 1 | 1 | 0 | 0 | 1 | 1 | 1 | 0 | 1 | 0 | 0 | 0 | 1 | 0 | 0 | 0
 |  |  |  | T7 | ACC ← MDR, SP ← SP + 1 | LA_BAR, AS0, AS1, EDB_BAR, IS, RESET | 0 | 1 | 1 | 1 | 0 | 0 | 0 | 0 | 0 | 0 | 0 | 1 | 1 | 0 | 1 | 0 | 1 | 1 | 1 | 1 | 1 | 1 | 1 | 0 | 1 | 1 | 0 | 1 | 1 | 0 | 1 | 1 | 1 | 1 | 0 | 0 | 1 | 0 | 0 | 1
CALL address | 16H | Calls a subroutine | 14 | T5 | MAR ← PC | LM_BAR, EP_BAR, EM_BAR | 0 | 0 | 0 | 1 | 0 | 0 | 0 | 0 | 0 | 0 | 0 | 1 | 1 | 0 | 0 | 0 | 1 | 1 | 1 | 1 | 1 | 1 | 1 | 1 | 1 | 1 | 0 | 1 | 1 | 1 | 1 | 1 | 0 | 0 | 0 | 0 | 0 | 0 | 0 | 0
 |  |  |  | T6 | PC← PC+1, MDR ← RAM[MAR] | CP, LDR_BAR, R_BAR, EM_BAR | 0 | 0 | 0 | 1 | 0 | 0 | 0 | 0 | 0 | 0 | 0 | 1 | 1 | 0 | 0 | 0 | 1 | 1 | 1 | 1 | 1 | 1 | 1 | 1 | 1 | 1 | 0 | 0 | 1 | 1 | 1 | 0 | 1 | 0 | 0 | 1 | 1 | 0 | 0 | 0
 |  |  |  | T7 | TEMP ← MDR, SP ← SP - 1 | LT_BAR, EDB_BAR, DS | 0 | 0 | 0 | 1 | 0 | 0 | 0 | 0 | 0 | 0 | 0 | 1 | 1 | 0 | 0 | 1 | 1 | 0 | 1 | 1 | 1 | 1 | 1 | 1 | 1 | 1 | 0 | 1 | 1 | 0 | 1 | 1 | 1 | 1 | 0 | 0 | 1 | 0 | 0 | 0
 |  |  |  | T8 | MAR ← SP | LM_BAR, ES_BAR | 0 | 0 | 0 | 1 | 0 | 0 | 0 | 0 | 0 | 0 | 0 | 1 | 1 | 0 | 0 | 0 | 0 | 1 | 1 | 1 | 1 | 1 | 1 | 1 | 1 | 1 | 0 | 1 | 1 | 1 | 1 | 1 | 0 | 1 | 0 | 0 | 1 | 0 | 0 | 0
 |  |  |  | T9 | MDR ← PC | LDR_BAR, EP_BAR, MEM_BUS | 0 | 0 | 0 | 1 | 0 | 0 | 0 | 0 | 0 | 0 | 0 | 1 | 1 | 0 | 0 | 0 | 1 | 1 | 1 | 1 | 1 | 1 | 1 | 1 | 1 | 1 | 1 | 0 | 1 | 1 | 1 | 1 | 1 | 1 | 0 | 0 | 0 | 0 | 0 | 0
 |  |  |  | T10 | RAM[MAR] ← MDR | EDR_BAR, EM_BAR | 0 | 0 | 0 | 1 | 0 | 0 | 0 | 0 | 0 | 0 | 0 | 1 | 1 | 0 | 0 | 0 | 1 | 1 | 1 | 1 | 1 | 1 | 1 | 1 | 1 | 1 | 0 | 1 | 0 | 1 | 1 | 1 | 1 | 0 | 0 | 0 | 1 | 0 | 0 | 0
 |  |  |  | T11 |  | W_BAR, EDR_BAR, EM_BAR | 0 | 0 | 0 | 1 | 0 | 0 | 0 | 0 | 0 | 0 | 0 | 1 | 1 | 0 | 0 | 0 | 1 | 1 | 1 | 1 | 1 | 1 | 1 | 1 | 1 | 1 | 0 | 1 | 0 | 1 | 0 | 1 | 1 | 0 | 0 | 0 | 1 | 0 | 0 | 0
 |  |  |  | T12 |  | EDR_BAR, EM_BAR | 0 | 0 | 0 | 1 | 0 | 0 | 0 | 0 | 0 | 0 | 0 | 1 | 1 | 0 | 0 | 0 | 1 | 1 | 1 | 1 | 1 | 1 | 1 | 1 | 1 | 1 | 0 | 1 | 0 | 1 | 1 | 1 | 1 | 0 | 0 | 0 | 1 | 0 | 0 | 0
 |  |  |  | T13 | PC ← TEMP | LP, ET_BAR | 0 | 0 | 0 | 1 | 0 | 0 | 0 | 0 | 0 | 0 | 0 | 1 | 1 | 0 | 0 | 0 | 1 | 1 | 0 | 1 | 1 | 1 | 1 | 1 | 1 | 1 | 0 | 1 | 1 | 1 | 1 | 1 | 1 | 1 | 0 | 0 | 1 | 1 | 0 | 0
 |  |  |  | T14 |  | CP, LP, RESET | 0 | 0 | 0 | 1 | 0 | 0 | 0 | 0 | 0 | 0 | 0 | 1 | 1 | 0 | 0 | 0 | 1 | 1 | 1 | 1 | 1 | 1 | 1 | 1 | 1 | 1 | 0 | 1 | 1 | 1 | 1 | 1 | 1 | 1 | 0 | 1 | 1 | 1 | 0 | 1
RET | 17H | Returns from current subroutine | 8 | T5 | MAR ← SP | LM_BAR, ES_BAR | 0 | 0 | 0 | 1 | 0 | 0 | 0 | 0 | 0 | 0 | 0 | 1 | 1 | 0 | 0 | 0 | 0 | 1 | 1 | 1 | 1 | 1 | 1 | 1 | 1 | 1 | 0 | 1 | 1 | 1 | 1 | 1 | 0 | 1 | 0 | 0 | 1 | 0 | 0 | 0
 |  |  |  | T6 | MDR ← RAM[MAR] | LDR_BAR, R_BAR, EM_BAR | 0 | 0 | 0 | 1 | 0 | 0 | 0 | 0 | 0 | 0 | 0 | 1 | 1 | 0 | 0 | 0 | 1 | 1 | 1 | 1 | 1 | 1 | 1 | 1 | 1 | 1 | 0 | 0 | 1 | 1 | 1 | 0 | 1 | 0 | 0 | 0 | 1 | 0 | 0 | 0
 |  |  |  | T7 | PC ← MDR, SP ← SP + 1 | LP, EDB_BAR, IS | 0 | 0 | 0 | 1 | 0 | 0 | 0 | 0 | 0 | 0 | 0 | 1 | 1 | 0 | 1 | 0 | 1 | 1 | 1 | 1 | 1 | 1 | 1 | 1 | 1 | 1 | 0 | 1 | 1 | 0 | 1 | 1 | 1 | 1 | 0 | 0 | 1 | 1 | 0 | 0
 |  |  |  | T8 |  | CP, LP, RESET | 0 | 0 | 0 | 1 | 0 | 0 | 0 | 0 | 0 | 0 | 0 | 1 | 1 | 0 | 0 | 0 | 1 | 1 | 1 | 1 | 1 | 1 | 1 | 1 | 1 | 1 | 0 | 1 | 1 | 1 | 1 | 1 | 1 | 1 | 0 | 1 | 1 | 1 | 0 | 1
SHL | 18H | ACC ← ACC << 1 | 6 | T5 | ACC ← ACC << 1 | EA_BAR | 0 | 0 | 0 | 1 | 0 | 0 | 0 | 0 | 0 | 0 | 0 | 1 | 1 | 0 | 0 | 0 | 1 | 1 | 1 | 1 | 1 | 1 | 0 | 1 | 1 | 1 | 0 | 1 | 1 | 1 | 1 | 1 | 1 | 1 | 0 | 0 | 1 | 0 | 0 | 0
 |  |  |  | T6 |  | LA_BAR, AS0, RESET | 0 | 1 | 0 | 1 | 0 | 0 | 0 | 0 | 0 | 0 | 0 | 1 | 1 | 0 | 0 | 0 | 1 | 1 | 1 | 1 | 1 | 1 | 0 | 0 | 1 | 1 | 0 | 1 | 1 | 1 | 1 | 1 | 1 | 1 | 0 | 0 | 1 | 0 | 0 | 1
SHR | 19H | ACC ← ACC >> 1 | 6 | T5 | ACC ← ACC >> 1 | EA_BAR | 0 | 0 | 0 | 1 | 0 | 0 | 0 | 0 | 0 | 0 | 0 | 1 | 1 | 0 | 0 | 0 | 1 | 1 | 1 | 1 | 1 | 1 | 0 | 1 | 1 | 1 | 0 | 1 | 1 | 1 | 1 | 1 | 1 | 1 | 0 | 0 | 1 | 0 | 0 | 0
 |  |  |  | T6 |  | LA_BAR, AS1, RESET | 0 | 0 | 1 | 1 | 0 | 0 | 0 | 0 | 0 | 0 | 0 | 1 | 1 | 0 | 0 | 0 | 1 | 1 | 1 | 1 | 1 | 1 | 0 | 0 | 1 | 1 | 0 | 1 | 1 | 1 | 1 | 1 | 1 | 1 | 0 | 0 | 1 | 0 | 0 | 1
JC address | 3AH | Jump if carry | 8 | T5 | MAR ← PC | LM_BAR, EP_BAR, EM_BAR | 0 | 0 | 0 | 1 | 0 | 0 | 0 | 0 | 0 | 0 | 0 | 1 | 1 | 0 | 0 | 0 | 1 | 1 | 1 | 1 | 1 | 1 | 1 | 1 | 1 | 1 | 0 | 1 | 1 | 1 | 1 | 1 | 0 | 0 | 0 | 0 | 0 | 0 | 0 | 0
 |  |  |  | T6 | PC← PC+1, MDR ← RAM[MAR] | CP, LDR_BAR, R_BAR, EM_BAR | 0 | 0 | 0 | 1 | 0 | 0 | 0 | 0 | 0 | 0 | 0 | 1 | 1 | 0 | 0 | 0 | 1 | 1 | 1 | 1 | 1 | 1 | 1 | 1 | 1 | 1 | 0 | 0 | 1 | 1 | 1 | 0 | 1 | 0 | 0 | 1 | 1 | 0 | 0 | 0
 |  |  |  | T7 | PC ← MDR | LP, EDB_BAR | 0 | 0 | 0 | 1 | 0 | 0 | 0 | 0 | 0 | 0 | 0 | 1 | 1 | 0 | 0 | 0 | 1 | 1 | 1 | 1 | 1 | 1 | 1 | 1 | 1 | 1 | 0 | 1 | 1 | 0 | 1 | 1 | 1 | 1 | 0 | 0 | 1 | 1 | 0 | 0
 |  |  |  | T8 |  | CP, LP, RESET | 0 | 0 | 0 | 1 | 0 | 0 | 0 | 0 | 0 | 0 | 0 | 1 | 1 | 0 | 0 | 0 | 1 | 1 | 1 | 1 | 1 | 1 | 1 | 1 | 1 | 1 | 0 | 1 | 1 | 1 | 1 | 1 | 1 | 1 | 0 | 1 | 1 | 1 | 0 | 1
JE address | 5BH | Jump if equal | 8 | T5 | MAR ← PC | LM_BAR, EP_BAR, EM_BAR | 0 | 0 | 0 | 1 | 0 | 0 | 0 | 0 | 0 | 0 | 0 | 1 | 1 | 0 | 0 | 0 | 1 | 1 | 1 | 1 | 1 | 1 | 1 | 1 | 1 | 1 | 0 | 1 | 1 | 1 | 1 | 1 | 0 | 0 | 0 | 0 | 0 | 0 | 0 | 0
 |  |  |  | T6 | PC← PC+1, MDR ← RAM[MAR] | CP, LDR_BAR, R_BAR, EM_BAR | 0 | 0 | 0 | 1 | 0 | 0 | 0 | 0 | 0 | 0 | 0 | 1 | 1 | 0 | 0 | 0 | 1 | 1 | 1 | 1 | 1 | 1 | 1 | 1 | 1 | 1 | 0 | 0 | 1 | 1 | 1 | 0 | 1 | 0 | 0 | 1 | 1 | 0 | 0 | 0
 |  |  |  | T7 | PC ← MDR | LP, EDB_BAR | 0 | 0 | 0 | 1 | 0 | 0 | 0 | 0 | 0 | 0 | 0 | 1 | 1 | 0 | 0 | 0 | 1 | 1 | 1 | 1 | 1 | 1 | 1 | 1 | 1 | 1 | 0 | 1 | 1 | 0 | 1 | 1 | 1 | 1 | 0 | 0 | 1 | 1 | 0 | 0
 |  |  |  | T8 |  | CP, LP, RESET | 0 | 0 | 0 | 1 | 0 | 0 | 0 | 0 | 0 | 0 | 0 | 1 | 1 | 0 | 0 | 0 | 1 | 1 | 1 | 1 | 1 | 1 | 1 | 1 | 1 | 1 | 0 | 1 | 1 | 1 | 1 | 1 | 1 | 1 | 0 | 1 | 1 | 1 | 0 | 1
if not jump | 1AH, 1BH |  | 5 | T5 | PC← PC+1 | CP, RESET | 0 | 0 | 0 | 1 | 0 | 0 | 0 | 0 | 0 | 0 | 0 | 1 | 1 | 0 | 0 | 0 | 1 | 1 | 1 | 1 | 1 | 1 | 1 | 1 | 1 | 1 | 0 | 1 | 1 | 1 | 1 | 1 | 1 | 1 | 0 | 1 | 1 | 0 | 0 | 1

Sheet: HEX
Macro-Instruction | Op-Code | Description | Total T-States | T-State | Micro-Operation | Active | CROM0 | CROM1 | CROM2 | CROM3 | CROM4
ALL | - | Fetch | 4 | T1 | MAR ← PC | LM_BAR, EP_BAR, EM_BAR | 10 | 18 | ff | df | 0
 |  |  |  | T2 | PC← PC+1, MDR ← RAM[MAR] | CP, LDR_BAR, R_BAR, EM_BAR | 10 | 18 | ff | ce | 98
 |  |  |  | T3 | IR ← MDR | EDB_BAR, LIR_BAR | 10 | 18 | ff | 9b | c8
 |  |  |  | T4 | LOAD from IR | LOAD | 10 | 18 | ff | df | ca
LDA address | 00H | ACC ← RAM[address] | 9 | T5 | MAR ← PC | LM_BAR, EP_BAR, EM_BAR | 10 | 18 | ff | df | 0
 |  |  |  | T6 | PC← PC+1, MDR ← RAM[MAR] | CP, LDR_BAR, R_BAR, EM_BAR | 10 | 18 | ff | ce | 98
 |  |  |  | T7 | MAR ← MDR | LM_BAR, EDB_BAR, EM_BAR | 10 | 18 | ff | db | 8
 |  |  |  | T8 | MDR ← RAM[MAR] | LDR_BAR, R_BAR, EM_BAR | 10 | 18 | ff | ce | 88
 |  |  |  | T9 | ACC ← MDR | LA_BAR, EDB_BAR, AS0, AS1, RESET | 70 | 18 | fe | db | c9
HALT | 0FH | Halts execution | 5 | T5 | HALT | HLT | 90 | 18 | ff | df | c8
IN | 02H | ACC ← input_port | 5 | T5 | ACC ← input_port | LA_BAR, AS0, AS1, EIN_BAR, RESET | 70 | 18 | fe | 5f | c9
STA address | 01H | RAM[address] ← ACC | 12 | T5 | MAR ← PC | LM_BAR, EP_BAR, EM_BAR | 10 | 18 | ff | df | 0
 |  |  |  | T6 | PC← PC+1, MDR ← RAM[MAR] | CP, LDR_BAR, R_BAR, EM_BAR | 10 | 18 | ff | ce | 98
 |  |  |  | T7 | MAR ← MDR | LM_BAR, EDB_BAR, EM_BAR | 10 | 18 | ff | db | 8
 |  |  |  | T8 | MDR ← ACC | LDR_BAR, EA_BAR, MEM_BUS, EM_BAR | 10 | 18 | fd | ef | 88
 |  |  |  | T9 | RAM[MAR] ← MDR | EDR_BAR, EM_BAR | 10 | 18 | ff | d7 | 88
 |  |  |  | T10 |  | W_BAR, EDR_BAR, EM_BAR | 10 | 18 | ff | d5 | 88
 |  |  |  | T11 |  | EDR_BAR, EM_BAR | 10 | 18 | ff | d7 | 88
 |  |  |  | T12 |  | R_BAR, RESET, EM_BAR | 10 | 18 | ff | de | 89
OUT | 03H | output_port ← ACC | 5 | T5 | output_port ← ACC | LO_BAR, EA_BAR, RESET | 10 | 18 | ed | df | c9
MOV B, ACC | 04H | B ← ACC | 5 | T5 | B ← ACC | LB_BAR, EA_BAR, RESET | 10 | 18 | f9 | df | c9
MOV ACC, B | 05H | ACC ← B | 5 | T5 | ACC ← B | LA_BAR, AS0, AS1, EB_BAR, RESET | 70 | 18 | f6 | df | c9
MOV ACC, immediate | 06H | ACC ← immediate | 7 | T5 | MAR ← PC | LM_BAR, EP_BAR, EM_BAR | 10 | 18 | ff | df | 0
 |  |  |  | T6 | PC← PC+1, MDR ← RAM[MAR] | CP, LDR_BAR, R_BAR, EM_BAR | 10 | 18 | ff | ce | 98
 |  |  |  | T7 | ACC ← MDR | LA_BAR, AS0, AS1, EDB_BAR, RESET | 70 | 18 | fe | db | c9
NOP | 07H | NOP | 5 | T5 | NOP | RESET | 10 | 18 | ff | df | c9
JMP address | 08H | Jump to the address | 8 | T5 | MAR ← PC | LM_BAR, EP_BAR, EM_BAR | 10 | 18 | ff | df | 0
 |  |  |  | T6 | PC← PC+1, MDR ← RAM[MAR] | CP, LDR_BAR, R_BAR, EM_BAR | 10 | 18 | ff | ce | 98
 |  |  |  | T7 | PC ← MDR | LP, EDB_BAR | 10 | 18 | ff | db | cc
 |  |  |  | T8 |  | CP, LP, RESET | 10 | 18 | ff | df | dd
ADD B | 09H | ACC ← ACC + B | 7 | T5 | TEMP ← B | LT_BAR, EB_BAR, S3, S0 | 14 | 98 | b7 | df | c8
 |  |  |  | T6 | ACC ← ACC + TEMP | S3, S0 | 14 | 98 | ff | df | c8
 |  |  |  | T7 |  | LA_BAR, AS0, AS1, EU_BAR, S3, S0, LF_BAR, RESET | 64 | 90 | fe | df | c9
ADC B | 0AH | ACC ← ACC + B + C | 7 | T5 | TEMP ← B | LT_BAR, EB_BAR, S3, S0, CIN0 | 14 | b8 | b7 | df | c8
 |  |  |  | T6 | ACC ← ACC + TEMP + C | S3, S0, CIN0 | 14 | b8 | ff | df | c8
 |  |  |  | T7 |  | LA_BAR, AS0, AS1, EU_BAR, S3, S0, CIN0, LF_BAR, RESET | 64 | b0 | fe | df | c9
SUB B | 0BH | ACC ← ACC - B | 7 | T5 | TEMP ← B | LT_BAR, EB_BAR, S2, S1, CIN1 | 13 | 58 | b7 | df | c8
 |  |  |  | T6 | ACC ← ACC - TEMP | S2, S1, CIN1 | 13 | 58 | ff | df | c8
 |  |  |  | T7 |  | LA_BAR, AS0, AS1, EU_BAR, S2, S1, CIN1, LF_BAR, RESET | 63 | 50 | fe | df | c9
SBB B | 0CH | ACC ← ACC - B - BO | 7 | T5 | TEMP ← B | LT_BAR, EB_BAR, S2, S1, CIN1, CIN0 | 13 | 78 | b7 | df | c8
 |  |  |  | T6 | ACC ← ACC - TEMP - BO | S2, S1, CIN1, CIN0 | 13 | 78 | ff | df | c8
 |  |  |  | T7 |  | LA_BAR, AS0, AS1, EU_BAR, S2, S1, CIN1, CIN0, LF_BAR, RESET | 63 | 70 | fe | df | c9
ADD immediate | 0DH | ACC ← ACC + immediate | 9 | T5 | MAR ← PC | LM_BAR, EP_BAR, EM_BAR | 10 | 18 | ff | df | 0
 |  |  |  | T6 | PC← PC+1, MDR ← RAM[MAR] | CP, LDR_BAR, R_BAR, EM_BAR | 10 | 18 | ff | ce | 98
 |  |  |  | T7 | TEMP ← MDR | LT_BAR, EDB_BAR, S3, S0 | 14 | 98 | bf | db | c8
 |  |  |  | T8 | ACC ← ACC + TEMP | S3, S0 | 14 | 98 | ff | df | c8
 |  |  |  | T9 |  | LA_BAR, AS0, AS1, EU_BAR, S3, S0, LF_BAR, RESET | 64 | 90 | fe | df | c9
SUB [address] | 0EH | ACC ← ACC - RAM[address] | 11 | T5 | MAR ← PC | LM_BAR, EP_BAR, EM_BAR | 10 | 18 | ff | df | 0
 |  |  |  | T6 | PC← PC+1, MDR ← RAM[MAR] | CP, LDR_BAR, R_BAR, EM_BAR | 10 | 18 | ff | ce | 98
 |  |  |  | T7 | MAR ← MDR | LM_BAR, EDB_BAR, EM_BAR | 10 | 18 | ff | db | 8
 |  |  |  | T8 | MDR ← RAM[MAR] | LDR_BAR, R_BAR, EM_BAR | 10 | 18 | ff | ce | 88
 |  |  |  | T9 | TEMP ← MDR | LT_BAR, EDB_BAR, S2, S1, CIN1 | 13 | 58 | bf | db | c8
 |  |  |  | T10 | ACC ← ACC - TEMP | S2, S1, CIN1 | 13 | 58 | ff | df | c8
 |  |  |  | T11 |  | LA_BAR, AS0, AS1, EU_BAR, S2, S1, CIN1, LF_BAR, RESET | 63 | 50 | fe | df | c9
CMP B | 10H | ACC - B | 7 | T5 | TEMP ← B | LT_BAR, EB_BAR, S2, S1, CIN1 | 13 | 58 | b7 | df | c8
 |  |  |  | T6 | ACC - TEMP | S2, S1, CIN1 | 13 | 58 | ff | df | c8
 |  |  |  | T7 |  | S2, S1, CIN1, LF_BAR, RESET | 3 | 58 | ff | df | c9
TEST B | 11H | ACC & B | 6 | T5 | TEMP ← B | LT_BAR, EB_BAR | 10 | 18 | b7 | df | c8
 |  |  |  | T6 | ACC & TEMP | LF_BAR, M, S3, S2, S1, RESET | f | 18 | ff | df | c9
AND B | 12H | ACC ← ACC & B | 6 | T5 | TEMP ← B | LT_BAR, EB_BAR | 10 | 18 | b7 | df | c8
 |  |  |  | T6 | ACC ← ACC & TEMP | LA_BAR, AS0, AS1, EU_BAR, M, S3, S2, S1, RESET | 7f | 10 | fe | df | c9
XOR immediate | 13H | ACC ← ACC ⊕ immediate | 8 | T5 | MAR ← PC | LM_BAR, EP_BAR, EM_BAR | 10 | 18 | ff | df | 0
 |  |  |  | T6 | PC← PC+1, MDR ← RAM[MAR] | CP, LDR_BAR, R_BAR, EM_BAR | 10 | 18 | ff | ce | 98
 |  |  |  | T7 | TEMP ← MDR | LT_BAR, EDB_BAR | 10 | 18 | bf | db | c8
 |  |  |  | T8 | ACC ← ACC ⊕ TEMP | LA_BAR, AS0, AS1, EU_BAR, M, S3, S0, RESET | 7c | 90 | fe | df | c9
PUSH | 14H | RAM[SP] ← ACC | 10 | T5 | SP ← SP - 1, MDR ← ACC | DS, LDR_BAR, EA_BAR, MEM_BUS, EM_BAR | 10 | 19 | fd | ef | 88
 |  |  |  | T6 | MAR ← SP | LM_BAR, ES_BAR, EM_BAR | 10 | 18 | 7f | df | 8
 |  |  |  | T7 | RAM[MAR] ← MDR | EDR_BAR, EM_BAR | 10 | 18 | ff | d7 | 88
 |  |  |  | T8 |  | W_BAR, EDR_BAR, EM_BAR | 10 | 18 | ff | d5 | 88
 |  |  |  | T9 |  | EDR_BAR, EM_BAR | 10 | 18 | ff | d7 | 88
 |  |  |  | T10 |  | R_BAR, RESET, EM_BAR | 10 | 18 | ff | de | 89
POP | 15H | ACC ← RAM[SP] | 7 | T5 | MAR ← SP | LM_BAR, ES_BAR, EM_BAR | 10 | 18 | 7f | df | 8
 |  |  |  | T6 | MDR ← RAM[MAR] | LDR_BAR, R_BAR, EM_BAR | 10 | 18 | ff | ce | 88
 |  |  |  | T7 | ACC ← MDR, SP ← SP + 1 | LA_BAR, AS0, AS1, EDB_BAR, IS, RESET | 70 | 1a | fe | db | c9
CALL address | 16H | Calls a subroutine | 14 | T5 | MAR ← PC | LM_BAR, EP_BAR, EM_BAR | 10 | 18 | ff | df | 0
 |  |  |  | T6 | PC← PC+1, MDR ← RAM[MAR] | CP, LDR_BAR, R_BAR, EM_BAR | 10 | 18 | ff | ce | 98
 |  |  |  | T7 | TEMP ← MDR, SP ← SP - 1 | LT_BAR, EDB_BAR, DS | 10 | 19 | bf | db | c8
 |  |  |  | T8 | MAR ← SP | LM_BAR, ES_BAR | 10 | 18 | 7f | df | 48
 |  |  |  | T9 | MDR ← PC | LDR_BAR, EP_BAR, MEM_BUS | 10 | 18 | ff | ef | c0
 |  |  |  | T10 | RAM[MAR] ← MDR | EDR_BAR, EM_BAR | 10 | 18 | ff | d7 | 88
 |  |  |  | T11 |  | W_BAR, EDR_BAR, EM_BAR | 10 | 18 | ff | d5 | 88
 |  |  |  | T12 |  | EDR_BAR, EM_BAR | 10 | 18 | ff | d7 | 88
 |  |  |  | T13 | PC ← TEMP | LP, ET_BAR | 10 | 18 | df | df | cc
 |  |  |  | T14 |  | CP, LP, RESET | 10 | 18 | ff | df | dd
RET | 17H | Returns from current subroutine | 8 | T5 | MAR ← SP | LM_BAR, ES_BAR | 10 | 18 | 7f | df | 48
 |  |  |  | T6 | MDR ← RAM[MAR] | LDR_BAR, R_BAR, EM_BAR | 10 | 18 | ff | ce | 88
 |  |  |  | T7 | PC ← MDR, SP ← SP + 1 | LP, EDB_BAR, IS | 10 | 1a | ff | db | cc
 |  |  |  | T8 |  | CP, LP, RESET | 10 | 18 | ff | df | dd
SHL | 18H | ACC ← ACC << 1 | 6 | T5 | ACC ← ACC << 1 | EA_BAR | 10 | 18 | fd | df | c8
 |  |  |  | T6 |  | LA_BAR, AS0, RESET | 50 | 18 | fc | df | c9
SHR | 19H | ACC ← ACC >> 1 | 6 | T5 | ACC ← ACC >> 1 | EA_BAR | 10 | 18 | fd | df | c8
 |  |  |  | T6 |  | LA_BAR, AS1, RESET | 30 | 18 | fc | df | c9
JC address | 1AH | Jump if carry | 8 | T5 | MAR ← PC | LM_BAR, EP_BAR, EM_BAR | 10 | 18 | ff | df | 0
 |  |  |  | T6 | PC← PC+1, MDR ← RAM[MAR] | CP, LDR_BAR, R_BAR, EM_BAR | 10 | 18 | ff | ce | 98
 |  |  |  | T7 | PC ← MDR | LP, EDB_BAR | 10 | 18 | ff | db | cc
 |  |  |  | T8 |  | CP, LP, RESET | 10 | 18 | ff | df | dd
JE address | 1BH | Jump if equal | 8 | T5 | MAR ← PC | LM_BAR, EP_BAR, EM_BAR | 10 | 18 | ff | df | 0
 |  |  |  | T6 | PC← PC+1, MDR ← RAM[MAR] | CP, LDR_BAR, R_BAR, EM_BAR | 10 | 18 | ff | ce | 98
 |  |  |  | T7 | PC ← MDR | LP, EDB_BAR | 10 | 18 | ff | db | cc
 |  |  |  | T8 |  | CP, LP, RESET | 10 | 18 | ff | df | dd
if not jump | 1AH, 1BH |  | 5 | T5 | PC← PC+1 | CP, RESET | 10 | 18 | ff | df | d9
