sakshar/4-bit_PC/sap_new.xlsx

Sheet: report
Macro-Instruction | Op-Code | Description | Total T-States | T-State | Micro-Operation | Active | HLT | AS1 | AS0 | LF_BAR | M | S3 | S2 | S1 | S0 | CIN1 | CIN0 | EF_BAR | EU_BAR | LS | IS | DS | ES_BAR | LT_BAR | ET_BAR | LO_BAR | EB_BAR | LB_BAR | EA_BAR | LA_BAR | EIN_BAR | LIR_BAR | MEM_BUS | LDR_BAR | EDR_BAR | EDB_BAR | W_BAR | R_BAR | LM_BAR | EM_BAR | CLEAR | CP | EP_BAR | LP | LOAD | RESET
ALL | - | Fetch | 4 | T1 | MAR ← PC | LM_BAR, EP_BAR, EM_BAR | 0 | 0 | 0 | 1 | 0 | 0 | 0 | 0 | 0 | 0 | 0 | 1 | 1 | 0 | 0 | 0 | 1 | 1 | 1 | 1 | 1 | 1 | 1 | 1 | 1 | 1 | 0 | 1 | 1 | 1 | 1 | 1 | 0 | 0 | 0 | 0 | 0 | 0 | 0 | 0
 |  |  |  | T2 | PC← PC+1, MDR ← RAM[MAR] | CP, LDR_BAR, R_BAR, EM_BAR | 0 | 0 | 0 | CE | 98
 |  |  |  | T3 | IR ← MDR | EDB_BAR, LIR_BAR | 10 | 18 | FF | 9B | C8
 |  |  |  | T4 | LOAD from IR | LOAD | 10 | 18 | FF | DF | CA
LDA address | 00H | ACC ← RAM[address] | 9 | T5 | MAR ← PC | LM_BAR, EP_BAR, EM_BAR | 10 | 18 | FF | DF | 0
 |  |  |  | T6 | PC← PC+1, MDR ← RAM[MAR] | CP, LDR_BAR, R_BAR, EM_BAR | 10 | 18 | FF | CE | 98
 |  |  |  | T7 | MAR ← MDR | LM_BAR, EDB_BAR, EM_BAR | 10 | 18 | FF | DB | 8
 |  |  |  | T8 | MDR ← RAM[MAR] | LDR_BAR, R_BAR, EM_BAR | 10 | 18 | FF | CE | 88
 |  |  |  | T9 | ACC ← MDR | LA_BAR, EDB_BAR, RESET | 10 | 18 | FE | DB | C9
HALT | 0FH | Halts execution | 5 | T5 | HALT | HLT | 50 | 18 | FF | DF | C8
IN | 02H | ACC ← input_port | 5 | T5 | ACC ← input_port | LA_BAR, EIN_BAR, RESET | 10 | 18 | FE | 5F | C9
STA address | 01H | RAM[address] ← ACC | 12 | T5 | MAR ← PC | LM_BAR, EP_BAR, EM_BAR | 10 | 18 | FF | DF | 0
 |  |  |  | T6 | PC← PC+1, MDR ← RAM[MAR] | CP, LDR_BAR, R_BAR, EM_BAR | 10 | 18 | FF | CE | 98
 |  |  |  | T7 | MAR ← MDR | LM_BAR, EDB_BAR, EM_BAR | 10 | 18 | FF | DB | 8
 |  |  |  | T8 | MDR ← ACC | LDR_BAR, EA_BAR, MEM_BUS, EM_BAR | 10 | 18 | FD | EF | 88
 |  |  |  | T9 | RAM[MAR] ← MDR | EDR_BAR, EM_BAR | 10 | 18 | FF | D7 | 88
 |  |  |  | T10 |  | W_BAR, EDR_BAR, EM_BAR | 10 | 18 | FF | D5 | 88
 |  |  |  | T11 |  | EDR_BAR, EM_BAR | 10 | 18 | FF | D7 | 88
 |  |  |  | T12 |  | R_BAR, RESET, EM_BAR | 10 | 18 | FF | DE | 89
OUT | 03H | output_port ← ACC | 5 | T5 | output_port ← ACC | LO_BAR, EA_BAR, RESET | 10 | 18 | ED | DF | C9
MOV B, ACC | 04H | B ← ACC | 5 | T5 | B ← ACC | LB_BAR, EA_BAR, RESET | 10 | 18 | F9 | DF | C9
MOV ACC, B | 05H | ACC ← B | 5 | T5 | ACC ← B | LA_BAR, EB_BAR, RESET | 10 | 18 | F6 | DF | C9
XCHG | 06H | ACC ↔ B | 7 | T5 | TEMP ← B | LT_BAR, EB_BAR | 10 | 18 | B7 | DF | C8
 |  |  |  | T6 | B ← ACC | LB_BAR, EA_BAR | 10 | 18 | F9 | DF | C8
 |  |  |  | T7 | ACC ← TEMP | LA_BAR, ET_BAR, RESET | 10 | 18 | DE | DF | C9
MOV ACC, immediate | 07H | ACC ← immediate | 7 | T5 | MAR ← PC | LM_BAR, EP_BAR, EM_BAR | 10 | 18 | FF | DF | 0
 |  |  |  | T6 | PC← PC+1, MDR ← RAM[MAR] | CP, LDR_BAR, R_BAR, EM_BAR | 10 | 18 | FF | CE | 98
 |  |  |  | T7 | ACC ← MDR | LA_BAR, EDB_BAR, RESET | 10 | 18 | FE | DB | C9
NOP | 08H | Jump to the address | 5 | T5 | NOP | RESET | 10 | 18 | FF | DF | C9
JMP address | 09H |  | 8 | T5 | MAR ← PC | LM_BAR, EP_BAR, EM_BAR | 10 | 18 | FF | DF | 0
 |  |  |  | T6 | PC← PC+1, MDR ← RAM[MAR] | CP, LDR_BAR, R_BAR, EM_BAR | 10 | 18 | FF | CE | 98
 |  |  |  | T7 | PC ← MDR | LP, EDB_BAR | 10 | 18 | FF | DB | CC
 |  |  |  | T8 |  | CP, LP, RESET | 10 | 18 | FF | DF | DD
ADD B | 0AH | ACC ← ACC + B | 7 | T5 | TEMP ← B | LT_BAR, EB_BAR, S3, S0 | 14 | 98 | B7 | DF | C8
 |  |  |  | T6 | ACC ← ACC + TEMP | S3, S0 | 14 | 98 | FF | DF | C8
 |  |  |  | T7 |  | LA_BAR, EU_BAR, S3, S0, LF_BAR, RESET | 4 | 90 | FE | DF | C9
ADC B | 0BH | ACC ← ACC + B + C | 7 | T5 | TEMP ← B | LT_BAR, EB_BAR, S3, S0, CIN0 | 14 | B8 | B7 | DF | C8
 |  |  |  | T6 | ACC ← ACC + TEMP + C | S3, S0, CIN0 | 14 | B8 | FF | DF | C8
 |  |  |  | T7 |  | LA_BAR, EU_BAR, S3, S0, CIN0, LF_BAR, RESET | 4 | B0 | FE | DF | C9
SUB B | 0CH | ACC ← ACC - B | 7 | T5 | TEMP ← B | LT_BAR, EB_BAR, S2, S1, CIN1 | 13 | 58 | B7 | DF | C8
 |  |  |  | T6 | ACC ← ACC - TEMP | S2, S1, CIN1 | 13 | 58 | FF | DF | C8
 |  |  |  | T7 |  | LA_BAR, EU_BAR, S2, S1, CIN1, LF_BAR, RESET | 3 | 50 | FE | DF | C9
SBB B | 0DH | ACC ← ACC - B - BO | 7 | T5 | TEMP ← B | LT_BAR, EB_BAR, S2, S1, CIN1, CIN0 | 13 | 78 | B7 | DF | C8
 |  |  |  | T6 | ACC ← ACC - TEMP - BO | S2, S1, CIN1, CIN0 | 13 | 78 | FF | DF | C8
 |  |  |  | T7 |  | LA_BAR, EU_BAR, S2, S1, CIN1, CIN0, LF_BAR, RESET | 3 | 70 | FE | DF | C9
ADD immediate | 0EH | ACC ← ACC + immediate | 9 | T5 | MAR ← PC | LM_BAR, EP_BAR, EM_BAR | 10 | 18 | FF | DF | 0
 |  |  |  | T6 | PC← PC+1, MDR ← RAM[MAR] | CP, LDR_BAR, R_BAR, EM_BAR | 10 | 18 | FF | CE | 98
 |  |  |  | T7 | TEMP ← MDR | LT_BAR, EDB_BAR, S3, S0 | 14 | 98 | BF | DB | C8
 |  |  |  | T8 | ACC ← ACC + TEMP | S3, S0 | 14 | 98 | FF | DF | C8
 |  |  |  | T9 |  | LA_BAR, EU_BAR, S3, S0, LF_BAR, RESET | 4 | 90 | FE | DF | C9
SUB immediate | 10H | ACC ← ACC - immediate | 9 | T5 | MAR ← PC | LM_BAR, EP_BAR, EM_BAR | 10 | 18 | FF | DF | 0
 |  |  |  | T6 | PC← PC+1, MDR ← RAM[MAR] | CP, LDR_BAR, R_BAR, EM_BAR | 10 | 18 | FF | CE | 98
 |  |  |  | T7 | TEMP ← MDR | LT_BAR, EDB_BAR, S2, S1, CIN1 | 13 | 58 | BF | DB | C8
 |  |  |  | T8 | ACC ← ACC - TEMP | S2, S1, CIN1 | 13 | 58 | FF | DF | C8
 |  |  |  | T9 |  | LA_BAR, EU_BAR, S2, S1, CIN1, LF_BAR, RESET | 3 | 50 | FE | DF | C9
CMP B | 11H | ACC - B | 7 | T5 | TEMP ← B | LT_BAR, EB_BAR, S2, S1, CIN1 | 13 | 58 | B7 | DF | C8
 |  |  |  | T6 | ACC - TEMP | S2, S1, CIN1 | 13 | 58 | FF | DF | C8
 |  |  |  | T7 |  | S2, S1, CIN1, LF_BAR, RESET | 3 | 58 | FF | DF | C9
NEG | 12H | ACC ← - ACC | 6 | T5 | ACC ← ACC' | LA_BAR, EU_BAR, M | 18 | 10 | FE | DF | C8
 |  |  |  | T6 | ACC ← ACC + 1 | LA_BAR, EU_BAR, S3, S2, S1, S0, CIN1, RESET | 17 | D0 | FE | DF | C9
OR [address] | 13H | ACC ← ACC | RAM[address] | 10 | T5 | MAR ← PC | LM_BAR, EP_BAR, EM_BAR | 10 | 18 | FF | DF | 0
 |  |  |  | T6 | PC← PC+1, MDR ← RAM[MAR] | CP, LDR_BAR, R_BAR, EM_BAR | 10 | 18 | FF | CE | 98
 |  |  |  | T7 | MAR ← MDR | LM_BAR, EDB_BAR, EM_BAR | 10 | 18 | FF | DB | 8
 |  |  |  | T8 | MDR ← RAM[MAR] | LDR_BAR, R_BAR, EM_BAR | 10 | 18 | FF | CE | 88
 |  |  |  | T9 | TEMP ← MDR | LT_BAR, EDB_BAR | 10 | 18 | BF | DB | C8
 |  |  |  | T10 | ACC ← ACC | TEMP | LA_BAR, EU_BAR, M, S3, S1, S0, RESET | 1D | 90 | FE | DF | C9
XOR B | 14H | ACC ← ACC ⊕ immediate | 9 | T5 | TEMP ← B | LT_BAR, EB_BAR | 10 | 18 | B7 | DF | C8
 |  |  |  | T6 | ACC ← ACC ⊕ TEMP | LA_BAR, EU_BAR, M, S3, S0, RESET | 1C | 90 | FE | DF | C9
PUSH | 15H | RAM[SP] ← ACC | 10 | T5 | SP ← SP - 1, MDR ← ACC | DS, LDR_BAR, EA_BAR, MEM_BUS, EM_BAR | 10 | 19 | FD | EF | 88
 |  |  |  | T6 | MAR ← SP | LM_BAR, ES_BAR, EM_BAR | 10 | 18 | 7F | DF | 8
 |  |  |  | T7 | RAM[MAR] ← MDR | EDR_BAR, EM_BAR | 10 | 18 | FF | D7 | 88
 |  |  |  | T8 |  | W_BAR, EDR_BAR, EM_BAR | 10 | 18 | FF | D5 | 88
 |  |  |  | T9 |  | EDR_BAR, EM_BAR | 10 | 18 | FF | D7 | 88
 |  |  |  | T10 |  | R_BAR, RESET, EM_BAR | 10 | 18 | FF | DE | 89
POP | 16H | ACC ← RAM[SP] | 7 | T5 | MAR ← SP | LM_BAR, ES_BAR, EM_BAR | 10 | 18 | 7F | DF | 8
 |  |  |  | T6 | MDR ← RAM[MAR] | LDR_BAR, R_BAR, EM_BAR | 10 | 18 | FF | CE | 88
 |  |  |  | T7 | ACC ← MDR, SP ← SP + 1 | LA_BAR, EDB_BAR, IS, RESET | 10 | 1A | FE | DB | C9
CALL address | 17H | Calls a subroutine | 14 | T5 | MAR ← PC | LM_BAR, EP_BAR, EM_BAR | 10 | 18 | FF | DF | 0
 |  |  |  | T6 | PC← PC+1, MDR ← RAM[MAR] | CP, LDR_BAR, R_BAR, EM_BAR | 10 | 18 | FF | CE | 98
 |  |  |  | T7 | TEMP ← MDR, SP ← SP - 1 | LT_BAR, EDB_BAR, DS | 10 | 19 | BF | DB | C8
 |  |  |  | T8 | MAR ← SP | LM_BAR, ES_BAR | 10 | 18 | 7F | DF | 48
 |  |  |  | T9 | MDR ← PC | LDR_BAR, EP_BAR, MEM_BUS | 10 | 18 | FF | EF | C0
 |  |  |  | T10 | RAM[MAR] ← MDR | EDR_BAR, EM_BAR | 10 | 18 | FF | D7 | 88
 |  |  |  | T11 |  | W_BAR, EDR_BAR, EM_BAR | 10 | 18 | FF | D5 | 88
 |  |  |  | T12 |  | EDR_BAR, EM_BAR | 10 | 18 | FF | D7 | 88
 |  |  |  | T13 | PC ← TEMP | LP, ET_BAR | 10 | 18 | DF | DF | CC
 |  |  |  | T14 |  | CP, LP, RESET | 10 | 18 | FF | DF | DD
RET | 18H | Returns from current subroutine | 8 | T5 | MAR ← SP | LM_BAR, ES_BAR | 10 | 18 | 7F | DF | 48
 |  |  |  | T6 | MDR ← RAM[MAR] | LDR_BAR, R_BAR, EM_BAR | 10 | 18 | FF | CE | 88
 |  |  |  | T7 | PC ← MDR, SP ← SP + 1 | LP, EDB_BAR, IS | 10 | 1A | FF | DB | CC
 |  |  |  | T8 |  | CP, LP, RESET | 10 | 18 | FF | DF | DD
CMC | 19H | CF ← CF' | 5 | T5 | CF ← CF' | CMC, LF_BAR, RESET | 20 | 18 | FF | DF | C9
JC address | 1AH | Jump if carry | 8 | T5 | MAR ← PC | LM_BAR, EP_BAR, EM_BAR | 10 | 18 | FF | DF | 0
 |  |  |  | T6 | PC← PC+1, MDR ← RAM[MAR] | CP, LDR_BAR, R_BAR, EM_BAR | 10 | 18 | FF | CE | 98
 |  |  |  | T7 | PC ← MDR | LP, EDB_BAR | 10 | 18 | FF | DB | CC
 |  |  |  | T8 |  | CP, LP, RESET | 10 | 18 | FF | DF | DD
JE address | 1BH | Jump if equal | 8 | T5 | MAR ← PC | LM_BAR, EP_BAR, EM_BAR | 10 | 18 | FF | DF | 0
 |  |  |  | T6 | PC← PC+1, MDR ← RAM[MAR] | CP, LDR_BAR, R_BAR, EM_BAR | 10 | 18 | FF | CE | 98
 |  |  |  | T7 | PC ← MDR | LP, EDB_BAR | 10 | 18 | FF | DB | CC
 |  |  |  | T8 |  | CP, LP, RESET | 10 | 18 | FF | DF | DD

Sheet: boot
W_BAR | R_BAR | CLR_ROM | CP_ROM
 |  |  |  |  | Write cycle.
1 | 1 | 0 | 0 | C | Default | RAM[Counter]←ROM[Counter], Counter←Counter+1
0 | 1 | 0 | 0 | 4 | Write.
1 | 1 | 0 | 1 | D | CP this.
1 | 1 | 1 | 0 | E | Clear | Restart boot-sequencer
 |  |  |  |  | Read cycle.
1 | 1 | 1 | 0 | E | Clear |  | E | 0 | 0 | 0
1 | 0 | 0 | 1 | 9 | CP this. |  | 9 | 0 | 0 | 0
1 | 0 | 0 | 0 | 8 | Don't CP this. |  | 8 | 0 | 0 | 0
 |  |  |  |  |  |  | 0 | 0 | 0 | 0

Sheet: seq
0 | HLT | CMC | LF_BAR |  | M | S3 | S2 | S1 |  | S0 | CIN1 | CIN0 | EF_BAR |  | EU_BAR | LS | IS | DS |  | ES_BAR | LT_BAR | ET_BAR | LO_BAR |  | EB_BAR | LB_BAR | EA_BAR | LA_BAR |  | EIN_BAR | LIR_BAR | MEM_BUS | LDR_BAR |  | EDR_BAR | EDB_BAR | W_BAR | R_BAR |  | LM_BAR | EM_BAR | CLEAR | CP |  | EP_BAR | LP | LOAD | RESET |  | Active | CON |  |  |  |  | micro-instruction | macro-instruction | opcode | adrs
0 | 0 | 0 | 1 | #NAME? | 0 | 0 | 0 | 0 | #NAME? | 0 | 0 | 0 | 1 | #NAME? | 1 | 0 | 0 | 0 | #NAME? | 1 | 1 | 1 | 1 | #NAME? | 1 | 1 | 1 | 1 | #NAME? | 1 | 1 | 0 | 1 | #NAME? | 1 | 1 | 1 | 1 | #NAME? | 1 | 1 | 0 | 0 | #NAME? | 1 | 0 | 0 | 0 | #NAME? | DEFAULT | #NAME? | #NAME? | #NAME? | #NAME? | #NAME? | DEFAULT | - | -
0 | 0 | 0 | 1 | #NAME? | 0 | 0 | 0 | 0 | #NAME? | 0 | 0 | 0 | 1 | #NAME? | 1 | 0 | 0 | 0 | #NAME? | 1 | 1 | 1 | 1 | #NAME? | 1 | 1 | 1 | 1 | #NAME? | 1 | 1 | 0 | 1 | #NAME? | 1 | 1 | 1 | 1 | #NAME? | 0 | 0 | 0 | 0 | #NAME? | 0 | 0 | 0 | 0 | #NAME? | LM_BAR, EP_BAR, EM_BAR | #NAME? | #NAME? | #NAME? | #NAME? | #NAME? | MAR ← PC | FETCH | -
0 | 0 | 0 | 1 | #NAME? | 0 | 0 | 0 | 0 | #NAME? | 0 | 0 | 0 | 1 | #NAME? | 1 | 0 | 0 | 0 | #NAME? | 1 | 1 | 1 | 1 | #NAME? | 1 | 1 | 1 | 1 | #NAME? | 1 | 1 | 0 | 0 | #NAME? | 1 | 1 | 1 | 0 | #NAME? | 1 | 0 | 0 | 1 | #NAME? | 1 | 0 | 0 | 0 | #NAME? | CP, LDR_BAR, R_BAR, EM_BAR | #NAME? | #NAME? | #NAME? | #NAME? | #NAME? | PC← PC+1, MDR ← RAM[MAR]
0 | 0 | 0 | 1 | #NAME? | 0 | 0 | 0 | 0 | #NAME? | 0 | 0 | 0 | 1 | #NAME? | 1 | 0 | 0 | 0 | #NAME? | 1 | 1 | 1 | 1 | #NAME? | 1 | 1 | 1 | 1 | #NAME? | 1 | 0 | 0 | 1 | #NAME? | 1 | 0 | 1 | 1 | #NAME? | 1 | 1 | 0 | 0 | #NAME? | 1 | 0 | 0 | 0 | #NAME? | EDB_BAR, LIR_BAR | #NAME? | #NAME? | #NAME? | #NAME? | #NAME? | IR ← MDR
0 | 0 | 0 | 1 | #NAME? | 0 | 0 | 0 | 0 | #NAME? | 0 | 0 | 0 | 1 | #NAME? | 1 | 0 | 0 | 0 | #NAME? | 1 | 1 | 1 | 1 | #NAME? | 1 | 1 | 1 | 1 | #NAME? | 1 | 1 | 0 | 1 | #NAME? | 1 | 1 | 1 | 1 | #NAME? | 1 | 1 | 0 | 0 | #NAME? | 1 | 0 | 1 | 0 | #NAME? | LOAD | #NAME? | #NAME? | #NAME? | #NAME? | #NAME? | LOAD from IR
0 | 0 | 0 | 1 | #NAME? | 0 | 0 | 0 | 0 | #NAME? | 0 | 0 | 0 | 1 | #NAME? | 1 | 0 | 0 | 0 | #NAME? | 1 | 1 | 1 | 1 | #NAME? | 1 | 1 | 1 | 1 | #NAME? | 1 | 1 | 0 | 1 | #NAME? | 1 | 1 | 1 | 1 | #NAME? | 0 | 0 | 0 | 0 | #NAME? | 0 | 0 | 0 | 0 | #NAME? | LM_BAR, EP_BAR, EM_BAR | #NAME? | #NAME? | #NAME? | #NAME? | #NAME? | MAR ← PC | LDA | 0 | 4
0 | 0 | 0 | 1 | #NAME? | 0 | 0 | 0 | 0 | #NAME? | 0 | 0 | 0 | 1 | #NAME? | 1 | 0 | 0 | 0 | #NAME? | 1 | 1 | 1 | 1 | #NAME? | 1 | 1 | 1 | 1 | #NAME? | 1 | 1 | 0 | 0 | #NAME? | 1 | 1 | 1 | 0 | #NAME? | 1 | 0 | 0 | 1 | #NAME? | 1 | 0 | 0 | 0 | #NAME? | CP, LDR_BAR, R_BAR, EM_BAR | #NAME? | #NAME? | #NAME? | #NAME? | #NAME? | PC← PC+1, MDR ← RAM[MAR]
0 | 0 | 0 | 1 | #NAME? | 0 | 0 | 0 | 0 | #NAME? | 0 | 0 | 0 | 1 | #NAME? | 1 | 0 | 0 | 0 | #NAME? | 1 | 1 | 1 | 1 | #NAME? | 1 | 1 | 1 | 1 | #NAME? | 1 | 1 | 0 | 1 | #NAME? | 1 | 0 | 1 | 1 | #NAME? | 0 | 0 | 0 | 0 | #NAME? | 1 | 0 | 0 | 0 | #NAME? | LM_BAR, EDB_BAR, EM_BAR | #NAME? | #NAME? | #NAME? | #NAME? | #NAME? | MAR ← MDR
0 | 0 | 0 | 1 | #NAME? | 0 | 0 | 0 | 0 | #NAME? | 0 | 0 | 0 | 1 | #NAME? | 1 | 0 | 0 | 0 | #NAME? | 1 | 1 | 1 | 1 | #NAME? | 1 | 1 | 1 | 1 | #NAME? | 1 | 1 | 0 | 0 | #NAME? | 1 | 1 | 1 | 0 | #NAME? | 1 | 0 | 0 | 0 | #NAME? | 1 | 0 | 0 | 0 | #NAME? | LDR_BAR, R_BAR, EM_BAR | #NAME? | #NAME? | #NAME? | #NAME? | #NAME? | MDR ← RAM[MAR]
0 | 0 | 0 | 1 | #NAME? | 0 | 0 | 0 | 0 | #NAME? | 0 | 0 | 0 | 1 | #NAME? | 1 | 0 | 0 | 0 | #NAME? | 1 | 1 | 1 | 1 | #NAME? | 1 | 1 | 1 | 0 | #NAME? | 1 | 1 | 0 | 1 | #NAME? | 1 | 0 | 1 | 1 | #NAME? | 1 | 1 | 0 | 0 | #NAME? | 1 | 0 | 0 | 1 | #NAME? | LA_BAR, EDB_BAR, RESET | #NAME? | #NAME? | #NAME? | #NAME? | #NAME? | ACC ← MDR
0 | 1 | 0 | 1 | #NAME? | 0 | 0 | 0 | 0 | #NAME? | 0 | 0 | 0 | 1 | #NAME? | 1 | 0 | 0 | 0 | #NAME? | 1 | 1 | 1 | 1 | #NAME? | 1 | 1 | 1 | 1 | #NAME? | 1 | 1 | 0 | 1 | #NAME? | 1 | 1 | 1 | 1 | #NAME? | 1 | 1 | 0 | 0 | #NAME? | 1 | 0 | 0 | 0 | #NAME? | HALT | #NAME? | #NAME? | #NAME? | #NAME? | #NAME? | HALT | HALT | F | 9
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
0 | 0 | 0 | 1 | #NAME? | 0 | 0 | 1 | 1 | #NAME? | 0 | 1 | 0 | 1 | #NAME? | 1 | 0 | 0 | 0 | #NAME? | 1 | 0 | 1 | 1 | #NAME? | 0 | 1 | 1 | 1 | #NAME? | 1 | 1 | 0 | 1 | #NAME? | 1 | 1 | 1 | 1 | #NAME? | 1 | 1 | 0 | 0 | #NAME? | 1 | 0 | 0 | 0 | #NAME? | LT_BAR, EB_BAR, S2, S1, CIN1 | #NAME? | #NAME? | #NAME? | #NAME? | #NAME? | TEMP ← B | CMP B | 11 | 37
0 | 0 | 0 | 1 | #NAME? | 0 | 0 | 1 | 1 | #NAME? | 0 | 1 | 0 | 1 | #NAME? | 1 | 0 | 0 | 0 | #NAME? | 1 | 1 | 1 | 1 | #NAME? | 1 | 1 | 1 | 1 | #NAME? | 1 | 1 | 0 | 1 | #NAME? | 1 | 1 | 1 | 1 | #NAME? | 1 | 1 | 0 | 0 | #NAME? | 1 | 0 | 0 | 0 | #NAME? | S2, S1, CIN1 | #NAME? | #NAME? | #NAME? | #NAME? | #NAME? | ACC - TEMP
0 | 0 | 0 | 0 | #NAME? | 0 | 0 | 1 | 1 | #NAME? | 0 | 1 | 0 | 1 | #NAME? | 1 | 0 | 0 | 0 | #NAME? | 1 | 1 | 1 | 1 | #NAME? | 1 | 1 | 1 | 1 | #NAME? | 1 | 1 | 0 | 1 | #NAME? | 1 | 1 | 1 | 1 | #NAME? | 1 | 1 | 0 | 0 | #NAME? | 1 | 0 | 0 | 1 | #NAME? | S2, S1, CIN1, LF_BAR, RESET | #NAME? | #NAME? | #NAME? | #NAME? | #NAME?
0 | 0 | 0 | 1 | #NAME? | 1 | 0 | 0 | 0 | #NAME? | 0 | 0 | 0 | 1 | #NAME? | 0 | 0 | 0 | 0 | #NAME? | 1 | 1 | 1 | 1 | #NAME? | 1 | 1 | 1 | 0 | #NAME? | 1 | 1 | 0 | 1 | #NAME? | 1 | 1 | 1 | 1 | #NAME? | 1 | 1 | 0 | 0 | #NAME? | 1 | 0 | 0 | 0 | #NAME? | LA_BAR, EU_BAR, M | #NAME? | #NAME? | #NAME? | #NAME? | #NAME? | ACC ← ACC' | NEG | 12 | 3A
0 | 0 | 0 | 1 | #NAME? | 0 | 1 | 1 | 1 | #NAME? | 1 | 1 | 0 | 1 | #NAME? | 0 | 0 | 0 | 0 | #NAME? | 1 | 1 | 1 | 1 | #NAME? | 1 | 1 | 1 | 0 | #NAME? | 1 | 1 | 0 | 1 | #NAME? | 1 | 1 | 1 | 1 | #NAME? | 1 | 1 | 0 | 0 | #NAME? | 1 | 0 | 0 | 1 | #NAME? | LA_BAR, EU_BAR, S3, S2, S1, S0, CIN1, RESET | #NAME? | #NAME? | #NAME? | #NAME? | #NAME? | ACC ← ACC' + 1
0 | 0 | 0 | 1 | #NAME? | 0 | 0 | 0 | 0 | #NAME? | 0 | 0 | 0 | 1 | #NAME? | 1 | 0 | 0 | 0 | #NAME? | 1 | 1 | 1 | 1 | #NAME? | 1 | 1 | 1 | 1 | #NAME? | 1 | 1 | 0 | 1 | #NAME? | 1 | 1 | 1 | 1 | #NAME? | 0 | 0 | 0 | 0 | #NAME? | 0 | 0 | 0 | 0 | #NAME? | LM_BAR, EP_BAR, EM_BAR | #NAME? | #NAME? | #NAME? | #NAME? | #NAME? | MAR ← PC | OR [ADDR] | 13 | 3C
0 | 0 | 0 | 1 | #NAME? | 0 | 0 | 0 | 0 | #NAME? | 0 | 0 | 0 | 1 | #NAME? | 1 | 0 | 0 | 0 | #NAME? | 1 | 1 | 1 | 1 | #NAME? | 1 | 1 | 1 | 1 | #NAME? | 1 | 1 | 0 | 0 | #NAME? | 1 | 1 | 1 | 0 | #NAME? | 1 | 0 | 0 | 1 | #NAME? | 1 | 0 | 0 | 0 | #NAME? | CP, LDR_BAR, R_BAR, EM_BAR | #NAME? | #NAME? | #NAME? | #NAME? | #NAME? | PC← PC+1, MDR ← RAM[MAR]
0 | 0 | 0 | 1 | #NAME? | 0 | 0 | 0 | 0 | #NAME? | 0 | 0 | 0 | 1 | #NAME? | 1 | 0 | 0 | 0 | #NAME? | 1 | 1 | 1 | 1 | #NAME? | 1 | 1 | 1 | 1 | #NAME? | 1 | 1 | 0 | 1 | #NAME? | 1 | 0 | 1 | 1 | #NAME? | 0 | 0 | 0 | 0 | #NAME? | 1 | 0 | 0 | 0 | #NAME? | LM_BAR, EDB_BAR, EM_BAR | #NAME? | #NAME? | #NAME? | #NAME? | #NAME? | MAR ← MDR
0 | 0 | 0 | 1 | #NAME? | 0 | 0 | 0 | 0 | #NAME? | 0 | 0 | 0 | 1 | #NAME? | 1 | 0 | 0 | 0 | #NAME? | 1 | 1 | 1 | 1 | #NAME? | 1 | 1 | 1 | 1 | #NAME? | 1 | 1 | 0 | 0 | #NAME? | 1 | 1 | 1 | 0 | #NAME? | 1 | 0 | 0 | 0 | #NAME? | 1 | 0 | 0 | 0 | #NAME? | LDR_BAR, R_BAR, EM_BAR | #NAME? | #NAME? | #NAME? | #NAME? | #NAME? | MDR ← RAM[MAR]
0 | 0 | 0 | 1 | #NAME? | 0 | 0 | 0 | 0 | #NAME? | 0 | 0 | 0 | 1 | #NAME? | 1 | 0 | 0 | 0 | #NAME? | 1 | 0 | 1 | 1 | #NAME? | 1 | 1 | 1 | 1 | #NAME? | 1 | 1 | 0 | 1 | #NAME? | 1 | 0 | 1 | 1 | #NAME? | 1 | 1 | 0 | 0 | #NAME? | 1 | 0 | 0 | 0 | #NAME? | LT_BAR, EDB_BAR | #NAME? | #NAME? | #NAME? | #NAME? | #NAME? | TEMP ← MDR
0 | 0 | 0 | 1 | #NAME? | 1 | 1 | 0 | 1 | #NAME? | 1 | 0 | 0 | 1 | #NAME? | 0 | 0 | 0 | 0 | #NAME? | 1 | 1 | 1 | 1 | #NAME? | 1 | 1 | 1 | 0 | #NAME? | 1 | 1 | 0 | 1 | #NAME? | 1 | 1 | 1 | 1 | #NAME? | 1 | 1 | 0 | 0 | #NAME? | 1 | 0 | 0 | 1 | #NAME? | LA_BAR, EU_BAR, M, S3, S1, S0, RESET | #NAME? | #NAME? | #NAME? | #NAME? | #NAME? | ACC ← ACC | TEMP
0 | 0 | 0 | 1 | #NAME? | 0 | 0 | 0 | 0 | #NAME? | 0 | 0 | 0 | 1 | #NAME? | 1 | 0 | 0 | 0 | #NAME? | 1 | 0 | 1 | 1 | #NAME? | 0 | 1 | 1 | 1 | #NAME? | 1 | 1 | 0 | 1 | #NAME? | 1 | 1 | 1 | 1 | #NAME? | 1 | 1 | 0 | 0 | #NAME? | 1 | 0 | 0 | 0 | #NAME? | LT_BAR, EB_BAR | #NAME? | #NAME? | #NAME? | #NAME? | #NAME? | TEMP ← B | XOR B | 14 | 42
0 | 0 | 0 | 1 | #NAME? | 1 | 1 | 0 | 0 | #NAME? | 1 | 0 | 0 | 1 | #NAME? | 0 | 0 | 0 | 0 | #NAME? | 1 | 1 | 1 | 1 | #NAME? | 1 | 1 | 1 | 0 | #NAME? | 1 | 1 | 0 | 1 | #NAME? | 1 | 1 | 1 | 1 | #NAME? | 1 | 1 | 0 | 0 | #NAME? | 1 | 0 | 0 | 1 | #NAME? | LA_BAR, EU_BAR, M, S3, S0, RESET | #NAME? | #NAME? | #NAME? | #NAME? | #NAME? | ACC ← ACC ⊕ TEMP
0 | 0 | 0 | 1 | #NAME? | 0 | 0 | 0 | 0 | #NAME? | 0 | 0 | 0 | 1 | #NAME? | 1 | 0 | 0 | 1 | #NAME? | 1 | 1 | 1 | 1 | #NAME? | 1 | 1 | 0 | 1 | #NAME? | 1 | 1 | 1 | 0 | #NAME? | 1 | 1 | 1 | 1 | #NAME? | 1 | 0 | 0 | 0 | #NAME? | 1 | 0 | 0 | 0 | #NAME? | DS, LDR_BAR, EA_BAR, MEM_BUS, EM_BAR | #NAME? | #NAME? | #NAME? | #NAME? | #NAME? | SP ← SP - 1, MDR ← ACC | PUSH | 15 | 44
0 | 0 | 0 | 1 | #NAME? | 0 | 0 | 0 | 0 | #NAME? | 0 | 0 | 0 | 1 | #NAME? | 1 | 0 | 0 | 0 | #NAME? | 0 | 1 | 1 | 1 | #NAME? | 1 | 1 | 1 | 1 | #NAME? | 1 | 1 | 0 | 1 | #NAME? | 1 | 1 | 1 | 1 | #NAME? | 0 | 0 | 0 | 0 | #NAME? | 1 | 0 | 0 | 0 | #NAME? | LM_BAR, ES_BAR, EM_BAR | #NAME? | #NAME? | #NAME? | #NAME? | #NAME? | MAR ← SP
0 | 0 | 0 | 1 | #NAME? | 0 | 0 | 0 | 0 | #NAME? | 0 | 0 | 0 | 1 | #NAME? | 1 | 0 | 0 | 0 | #NAME? | 1 | 1 | 1 | 1 | #NAME? | 1 | 1 | 1 | 1 | #NAME? | 1 | 1 | 0 | 1 | #NAME? | 0 | 1 | 1 | 1 | #NAME? | 1 | 0 | 0 | 0 | #NAME? | 1 | 0 | 0 | 0 | #NAME? | EDR_BAR, EM_BAR | #NAME? | #NAME? | #NAME? | #NAME? | #NAME? | RAM[MAR] ← MDR
0 | 0 | 0 | 1 | #NAME? | 0 | 0 | 0 | 0 | #NAME? | 0 | 0 | 0 | 1 | #NAME? | 1 | 0 | 0 | 0 | #NAME? | 1 | 1 | 1 | 1 | #NAME? | 1 | 1 | 1 | 1 | #NAME? | 1 | 1 | 0 | 1 | #NAME? | 0 | 1 | 0 | 1 | #NAME? | 1 | 0 | 0 | 0 | #NAME? | 1 | 0 | 0 | 0 | #NAME? | W_BAR, EDR_BAR, EM_BAR | #NAME? | #NAME? | #NAME? | #NAME? | #NAME?
0 | 0 | 0 | 1 | #NAME? | 0 | 0 | 0 | 0 | #NAME? | 0 | 0 | 0 | 1 | #NAME? | 1 | 0 | 0 | 0 | #NAME? | 1 | 1 | 1 | 1 | #NAME? | 1 | 1 | 1 | 1 | #NAME? | 1 | 1 | 0 | 1 | #NAME? | 0 | 1 | 1 | 1 | #NAME? | 1 | 0 | 0 | 0 | #NAME? | 1 | 0 | 0 | 0 | #NAME? | EDR_BAR, EM_BAR | #NAME? | #NAME? | #NAME? | #NAME? | #NAME?
0 | 0 | 0 | 1 | #NAME? | 0 | 0 | 0 | 0 | #NAME? | 0 | 0 | 0 | 1 | #NAME? | 1 | 0 | 0 | 0 | #NAME? | 1 | 1 | 1 | 1 | #NAME? | 1 | 1 | 1 | 1 | #NAME? | 1 | 1 | 0 | 1 | #NAME? | 1 | 1 | 1 | 0 | #NAME? | 1 | 0 | 0 | 0 | #NAME? | 1 | 0 | 0 | 1 | #NAME? | R_BAR, RESET, EM_BAR | #NAME? | #NAME? | #NAME? | #NAME? | #NAME?
0 | 0 | 0 | 1 | #NAME? | 0 | 0 | 0 | 0 | #NAME? | 0 | 0 | 0 | 1 | #NAME? | 1 | 0 | 0 | 0 | #NAME? | 0 | 1 | 1 | 1 | #NAME? | 1 | 1 | 1 | 1 | #NAME? | 1 | 1 | 0 | 1 | #NAME? | 1 | 1 | 1 | 1 | #NAME? | 0 | 0 | 0 | 0 | #NAME? | 1 | 0 | 0 | 0 | #NAME? | LM_BAR, ES_BAR, EM_BAR | #NAME? | #NAME? | #NAME? | #NAME? | #NAME? | MAR ← SP | POP | 16 | 4A
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
 |  |  |  |  |  |  |  |  |  |  |  |  |  |  |  |  |  |  |  |  |  |  |  |  |  |  |  |  |  |  |  |  |  |  |  |  |  |  |  | 0 | 1 | 0 | 1 | #NAME? | 1 | 0 | 1 | 1 | #NAME? | JO | 0 | 0 | 0 | 0 | #NAME?

Sheet: ic_count
Blocks | Input | Output | Control Signal |  | 74LS04 | 74LS08 | 74LS11 | 74LS32 | 74LS173 | 74LS181 | 74LS193 | 74LS244 | 6116
Input Port | IN0, IN1, IN2, IN3 | W0, W1, W2, W3 | EIN_BAR, CLK |  |  |  |  |  | 1 |  |  | 1
PC | W0, W1, W2, W3, W4, W5, W6, W7 | PC0,PC1,PC2,PC3,PC4,PC5,PC6,PC7 | LP, EP_BAR, CP |  |  | 1 |  |  |  |  | 2 | 2
MAR | W0, W1, W2, W3, W4, W5, W6, W7 | MO0, MO1, MO2, MO3, MO4, MO5, MO6, MO7,M0,M1,M2,M3,M4,M5,M6,M7 | EM_BAR,LM_BAR, CLK |  |  |  |  |  | 2 |  |  | 2
Memory | MO0, MO1, MO2, MO3, MO4, MO5, MO6, MO7,RM0,RM1,RM2,RM3,RM4,RM5,RM6,RM7 | RM0, RM1, RM2, RM3, RM4, RM5, RM6, RM7,R0,R1,R2,R3,R4,R5,R6,R7 | CLK,R_BAR, W_BAR,BT_BAR,HLT |  |  |  |  |  |  |  |  |  | 1
MDR | RM0, RM1, RM2, RM3, RM4, RM5, RM6, RM7, W0, W1, W2, W3, W4, W5, W6, W7 | RM0, RM1, RM2, RM3, RM4, RM5, RM6, RM7, W0, W1, W2, W3, W4, W5, W6, W7,MDR0,MDR1,MDR2,MDR3,MDR4,MDR5.MDR6.MDR7 | LDR_BAR, EDR_BAR,EDB_BAR, CLK,MEM_BUS |  |  |  |  |  | 2 |  |  | 4
IR | W0, W1, W2, W3, W4, W5, W6, W7 | CON0, CON1, CON2, CON3, CON4 | LIR_BAR, CLK |  |  |  |  |  | 2 |  |  | 2
Accumulator | W0, W1, W2, W3 | A0, A1, A2, A3 | LA_BAR, EA_BAR, CLK |  |  |  |  |  | 1 |  |  | 2
ALU | A0, A1, A2, A3, T0, T1, T2, T3 | W0, W1, W2, W3, OV, Z,S,C,F0,F1,F2,F3 | LF_BAR, EU_BAR, M, S0, S1, S2, S3, CIN1, CIN0,CLK,CMC |  | 2 | 2 | 1 | 2 |  | 1 |  | 1
Temp | W0, W1, W2, W3, W4, W5, W6, W7 | W0, W1, W2, W3, W4, W5, W6, W7,T0, T1, T2, T3,T4,T5,T6,T7 | LT_BAR, ET_BAR, CLK |  |  |  |  |  | 2 |  |  | 3
B Register | W0, W1, W2, W3 | W0, W1, W2, W3,B0,B1,B2,B3 | LB_BAR, EB_BAR, CLK |  |  |  |  |  | 1 |  |  | 1
SP | W0, W1, W2, W3, W4, W5, W6, W7 | W0, W1, W2, W3, W4, W5, W6, W7,SP0,SP1,SP2,SP3,SP4,SP5,SP6,SP7 | ES_BAR, BT_BAR, IS, DS |  |  | 2 |  |  |  |  | 2 | 2
Output Port | W0, W1, W2, W3 | OUT0, OUT1, OUT2, OUT3 | LO_BAR, CLK |  |  |  |  |  | 1 |  |  | 1
CON | CON0, CON1, CON2, CON3, CON4 | D0,D1,D2,D3,D4,D5,D6,D7,A5,A6,ZF,OVF | HLT,CMC,LF_BAR,M,S3,S2,S1,S0,CIN1,CIN0,EF_BAR,EU_BAR,LS,IS,DS,ES_BAR,LT_BAR,ET_BAR,LO_BAR,EB_BAR,LB_BAR,EA_BAR,LA_BAR,EIN_BAR,LIR_BAR,MEM_BUS,LDR_BAR,EDR_BAR,EDB_BAR,W_BAR,R_BAR,LM_BAR,EM_BAR,CLEAR,CP,EP_BAR,LP,LOAD,RESET,BT_BAR,CLK | TOTAL | 2 | 5 | 1 | 2 | 12 | 1 | 4 | 21 | 1

Sheet: Sheet8
74LS173 | 74LS244 | 74LS157 | COUNTER_8 | 74LS386 | 74LS04 | AND_4 | AND_3 | 74LS32 | 74LS181 | 74LS08 | OR_3 | 2732 | COUNTER_4 | 6116 | 74HC21
2+2+2+1+2+1+1+1+1+1+1=15 | 4+6+2+4+2+4+2+4+3+1+1+4=37 | 2+1+1+2=6 | 1+1+1+1=4 | 1 | 2+8+4+3+1+5+1=24 | 1+1=2 | 3 | 1 | 1 | 2+2+2=6 | 1 | 6+2=8 | 1 | 1 | 2
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
