sakshar/4-bit_PC/fourBit.pdf

# ES_BAR M

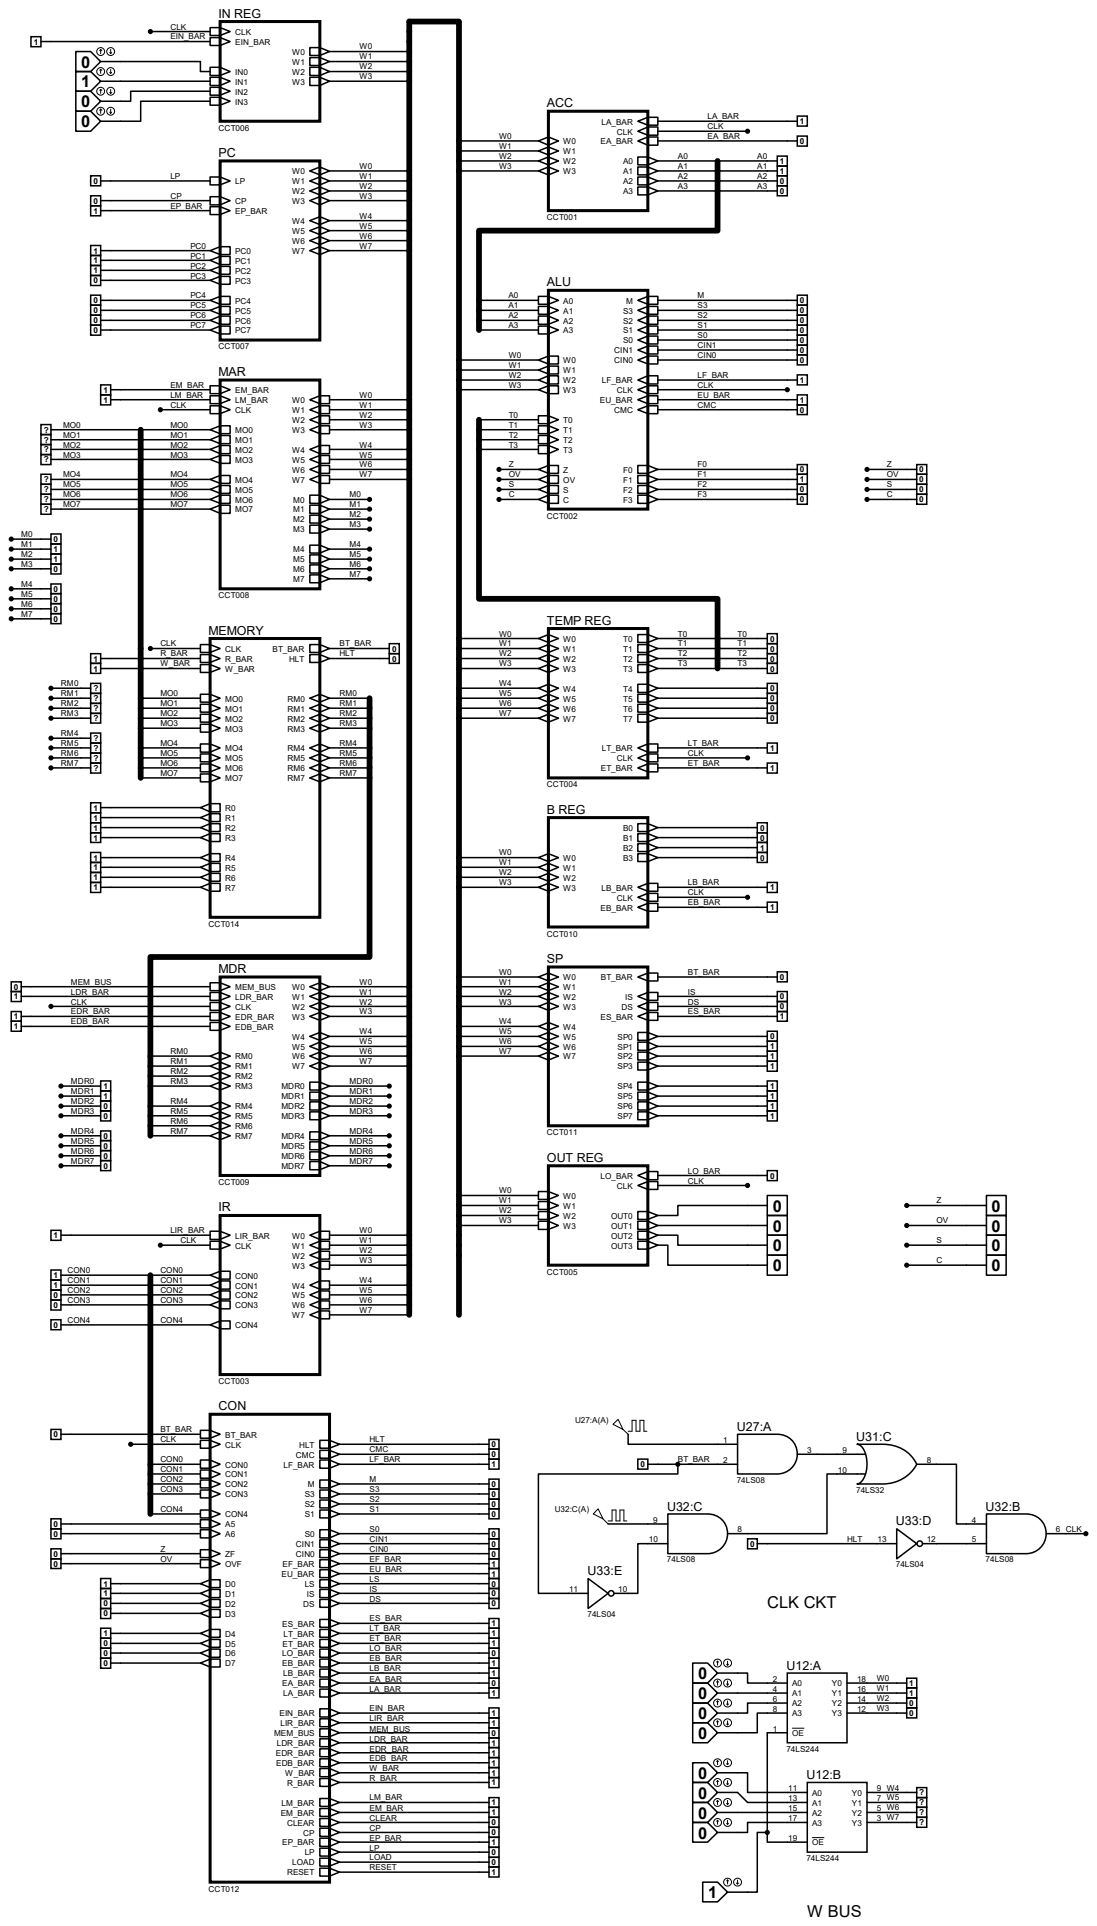
[picture p9: page 1]

U66:A

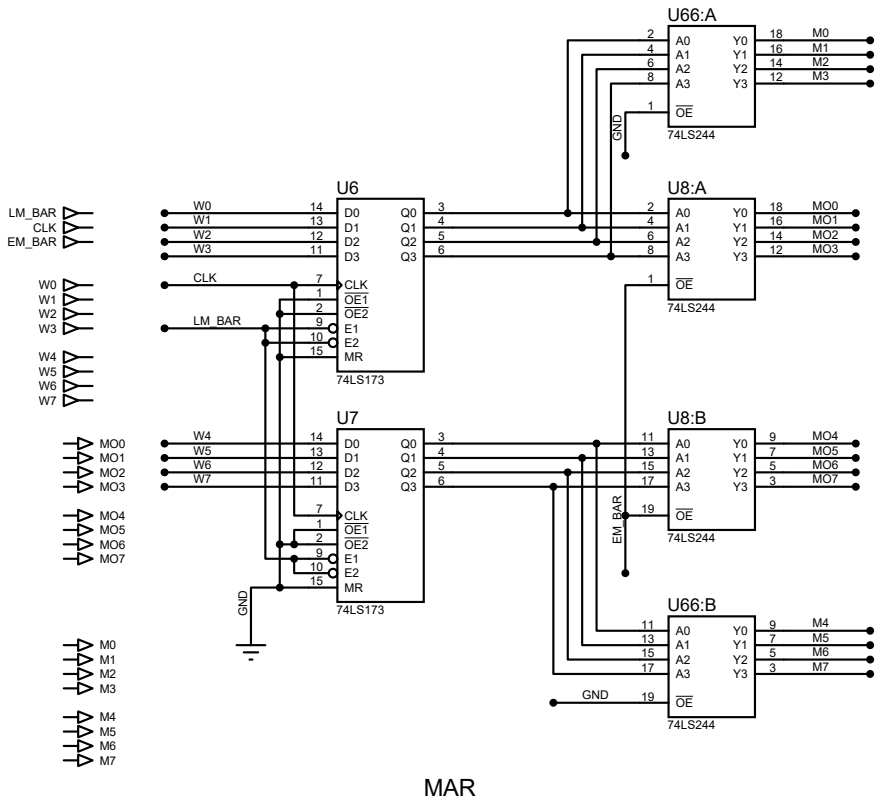
[picture p10: page 2]

U2

U10:A

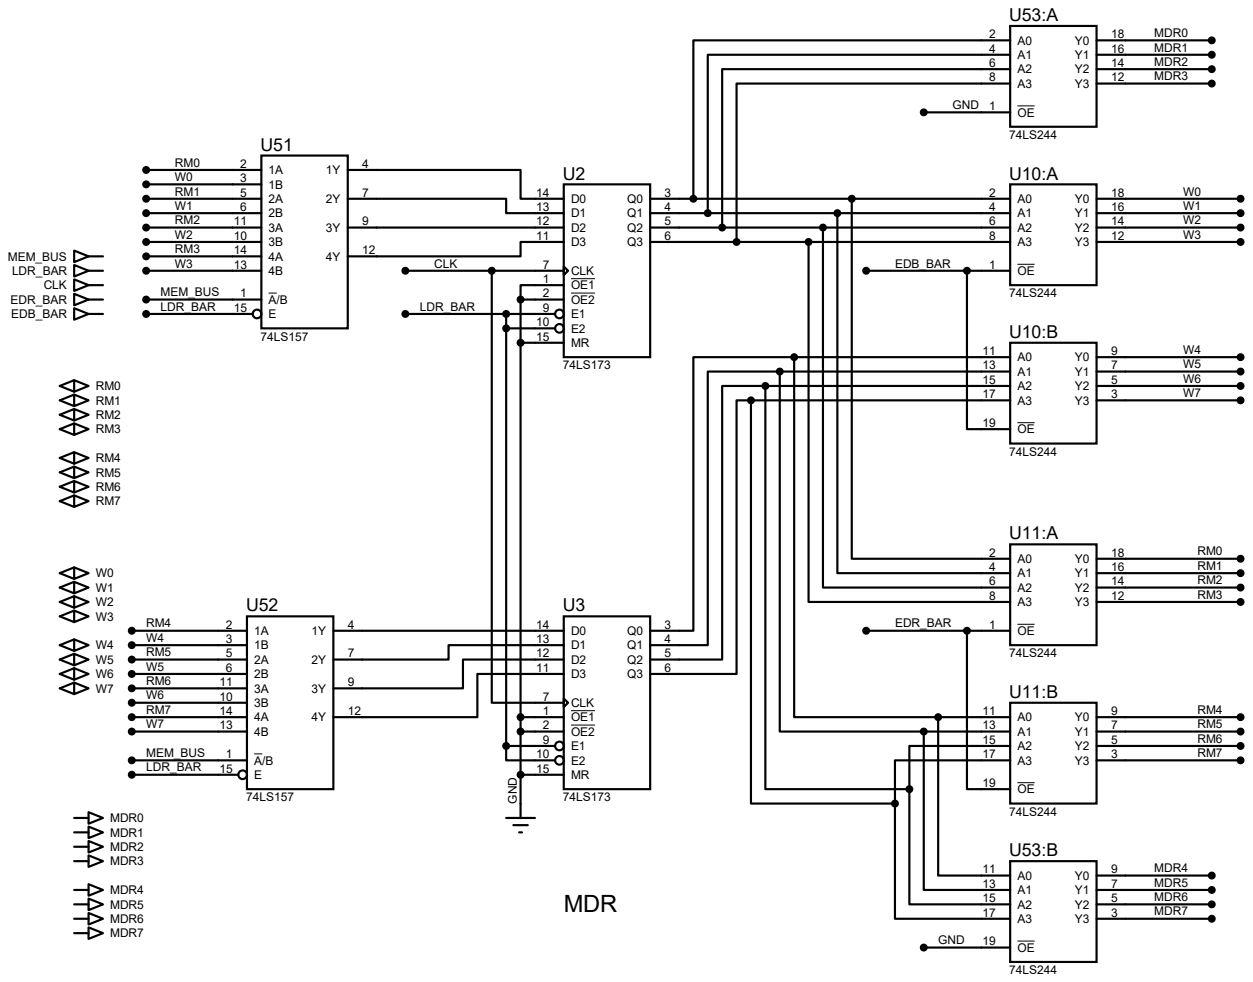
[picture p11: page 3]

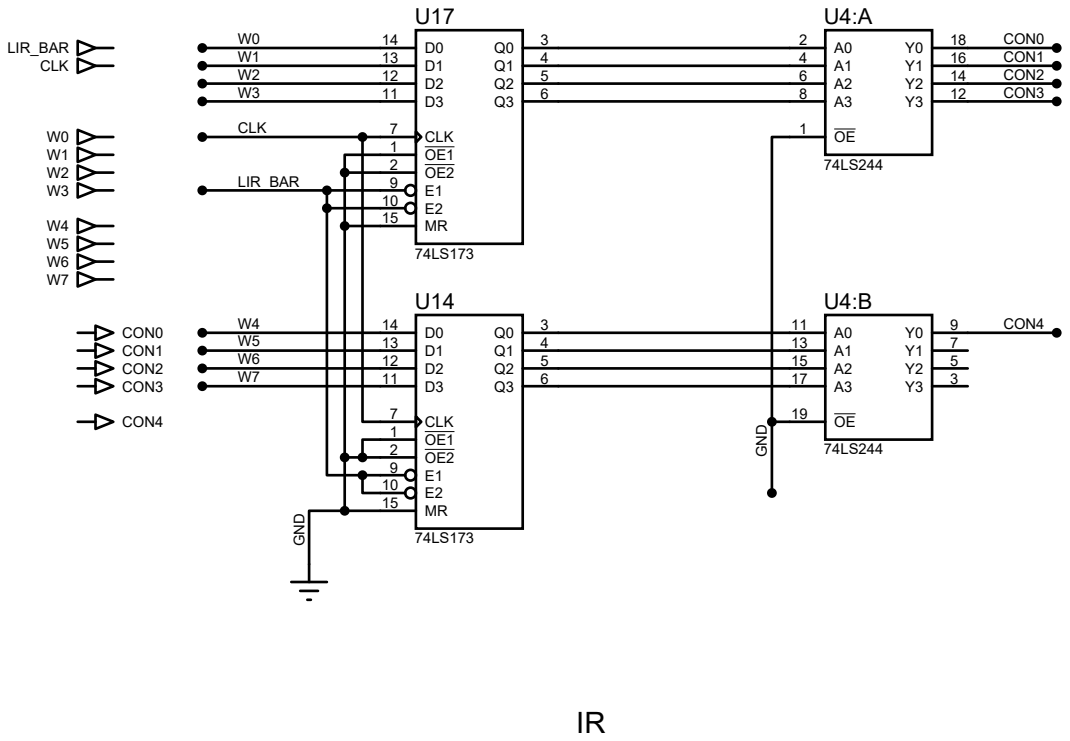
[picture p12: page 4]

U45:A

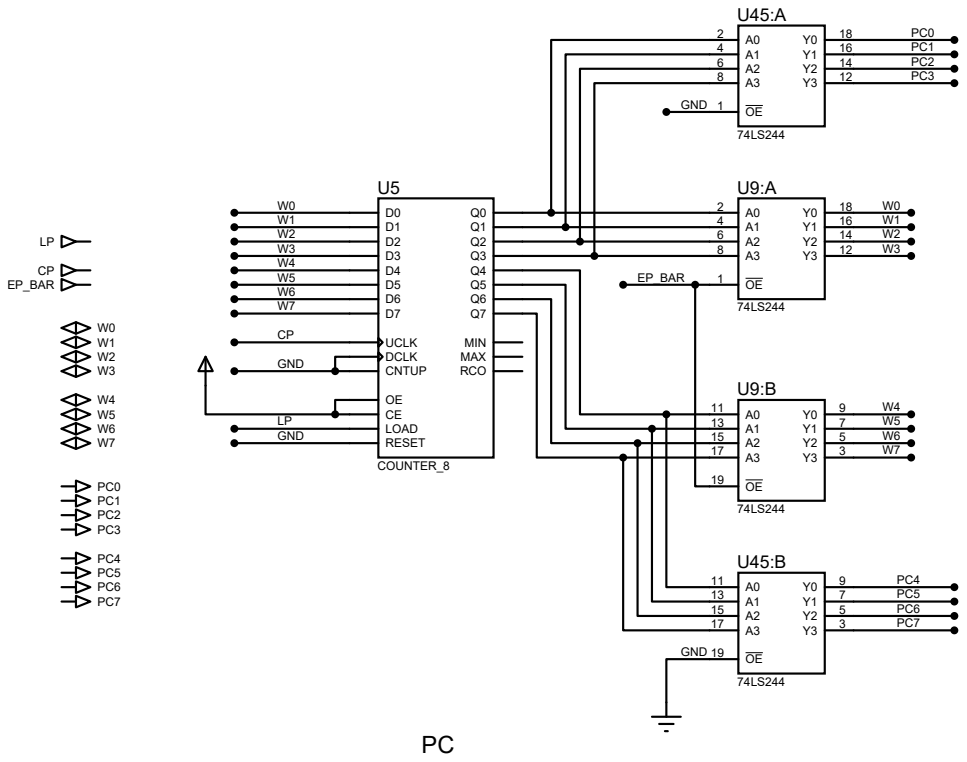
[picture p13: page 5]

GND | 1

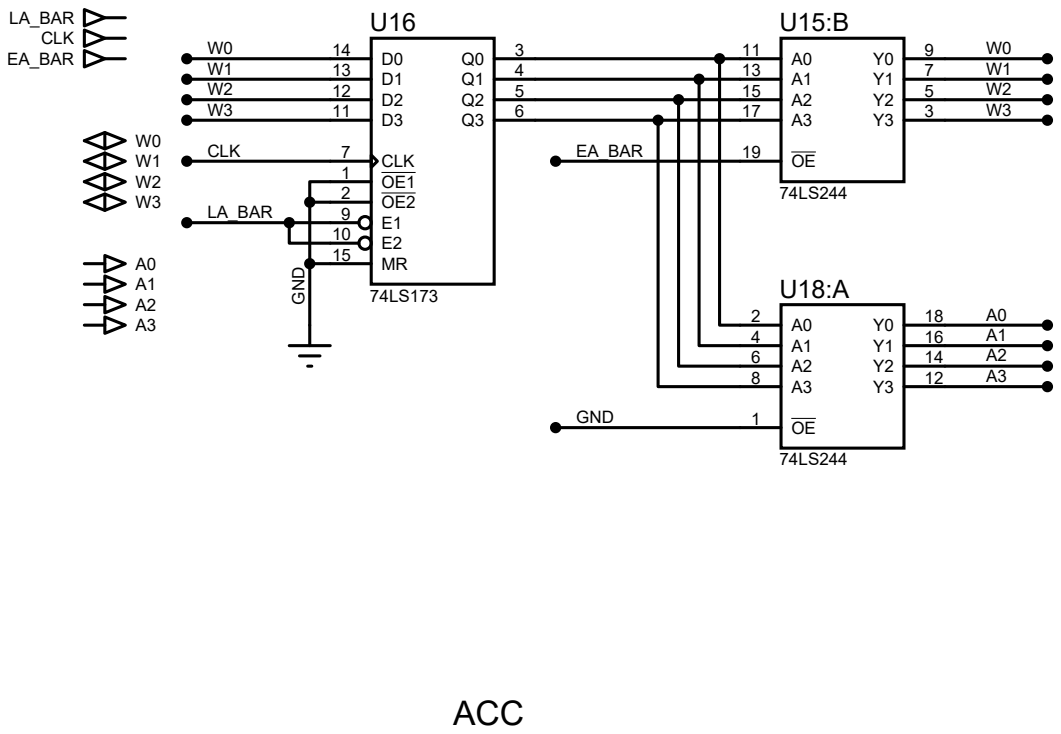
[picture p14: page 6]

4 | A1 13
5 | | A2 15

2 | | 74LS244 U18:A
9 | E2 10

U19

U18:B

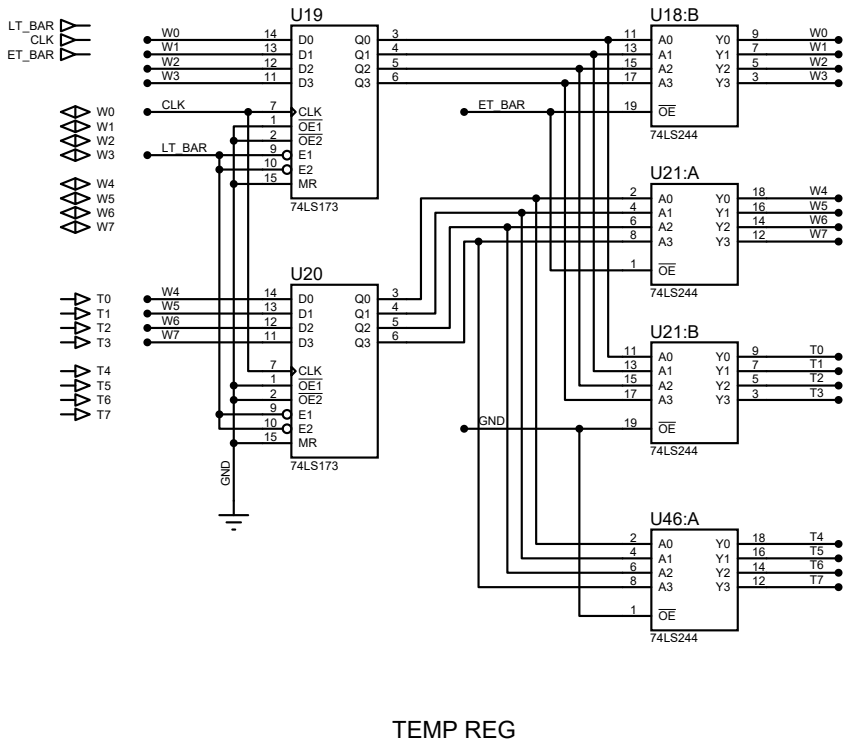
[picture p15: page 7]

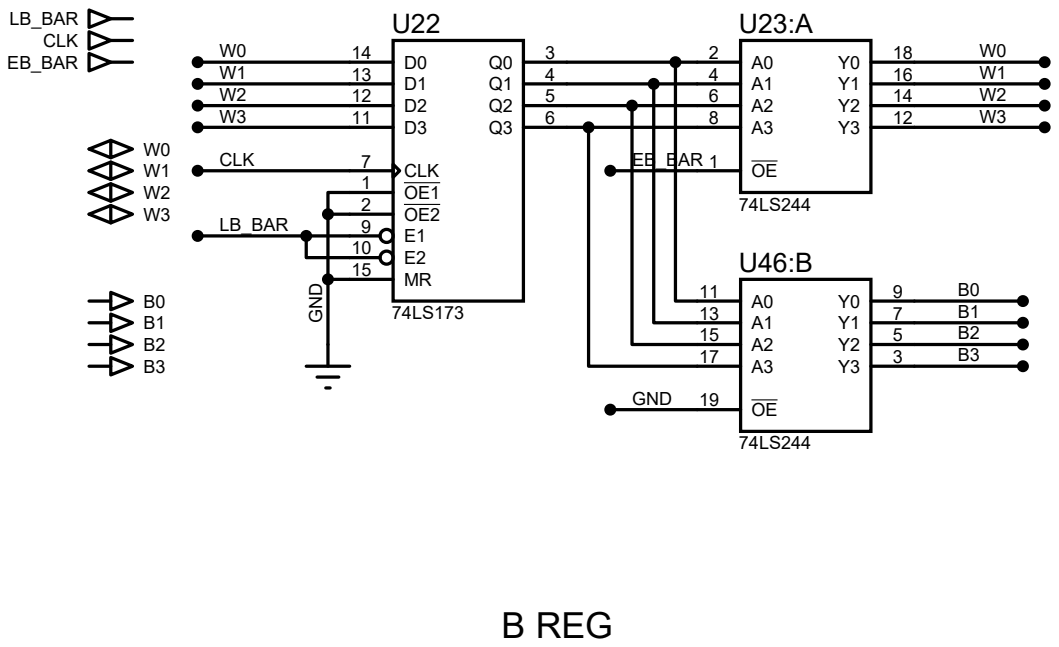
[picture p16: page 8]

2 | | 74LS244 U46:B
9 | E2 10

U25:A

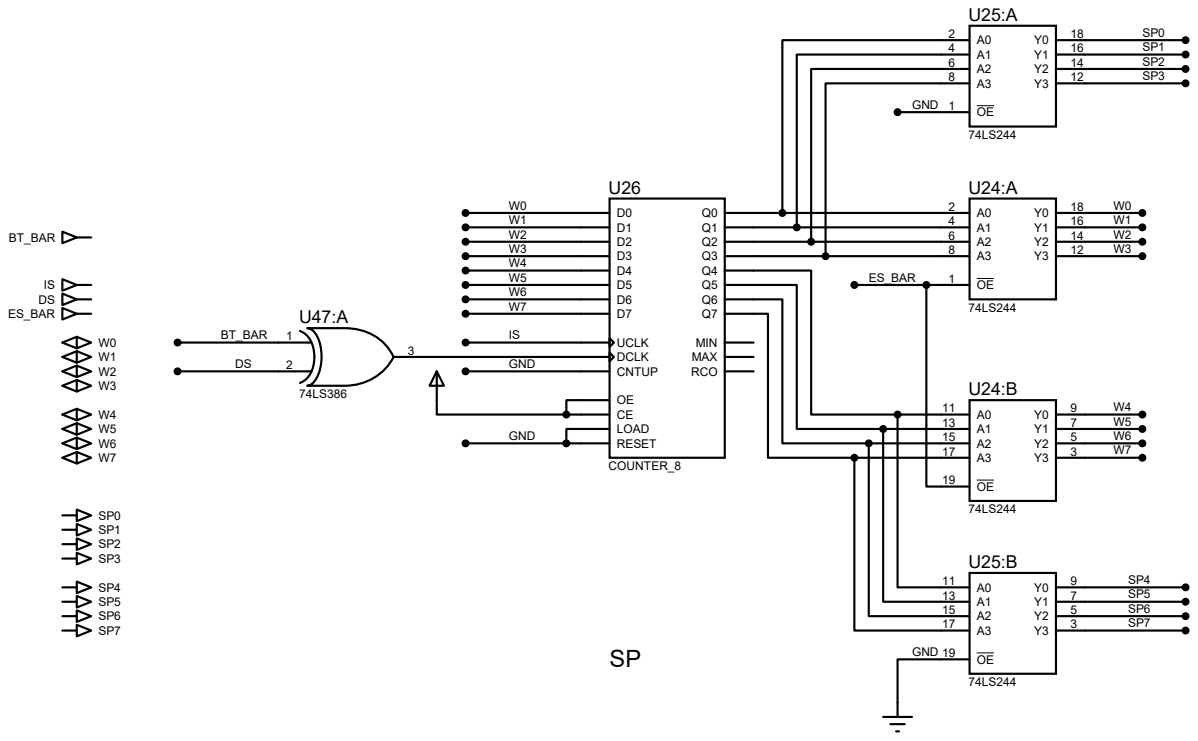
[picture p17: page 9]

GND | 1

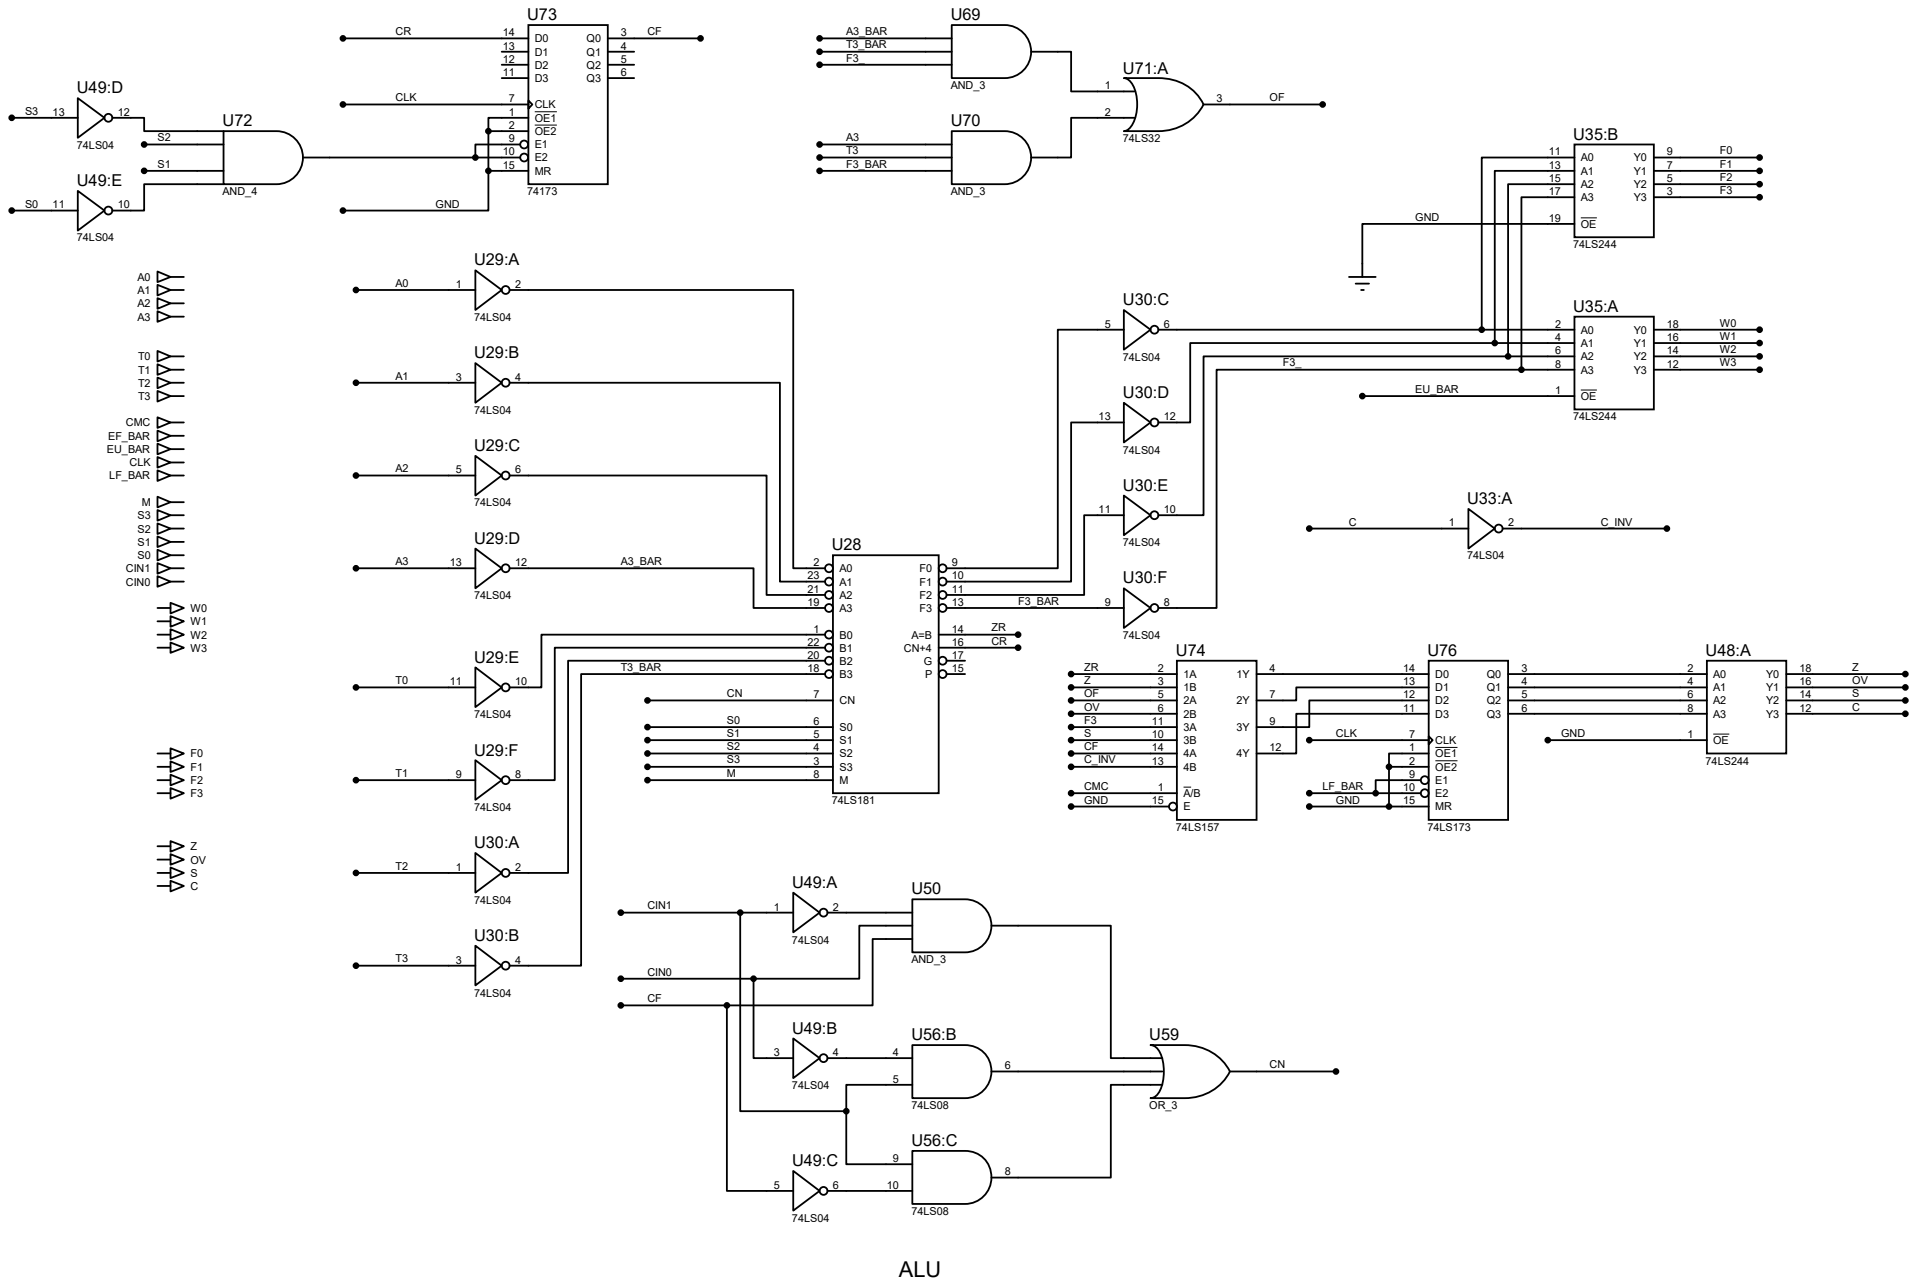
[picture p18: page 10]

EU_BAR | 1

CLK

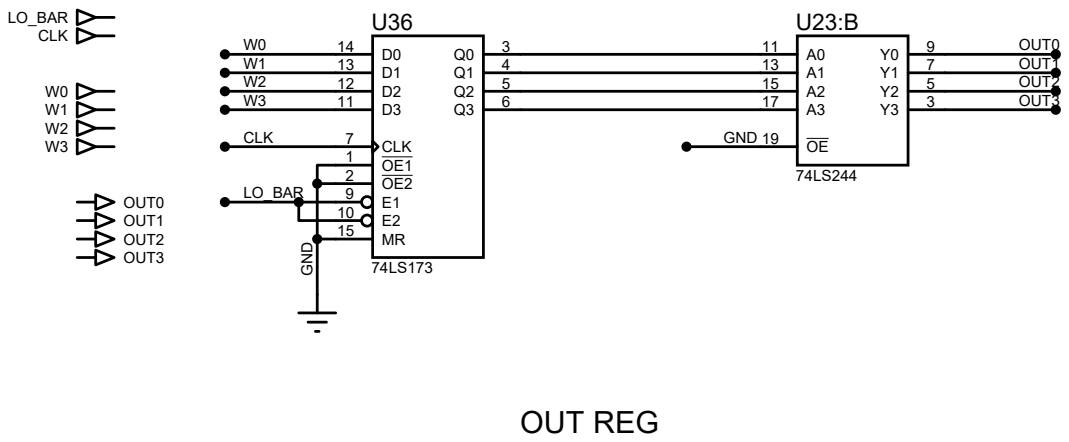
[picture p19: page 11]

9 | E2 10

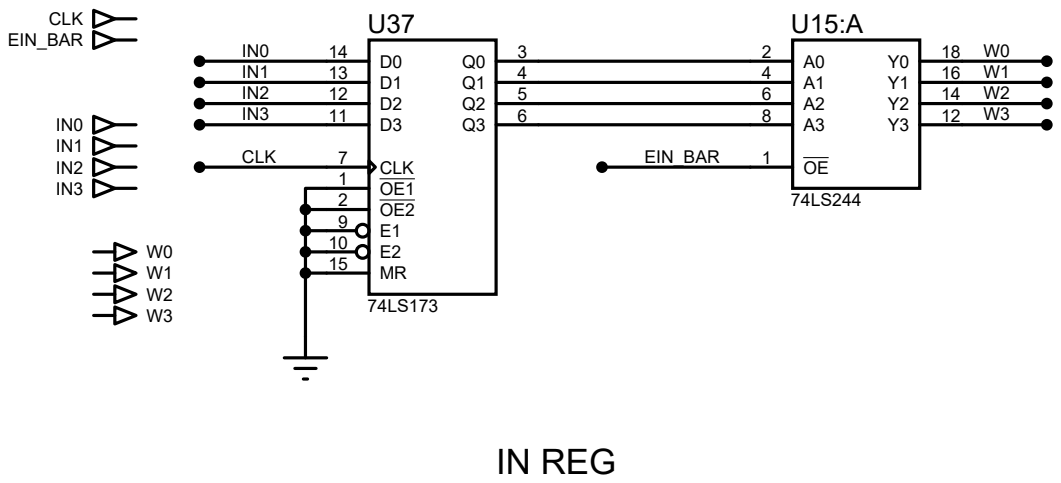
[picture p20: page 12]

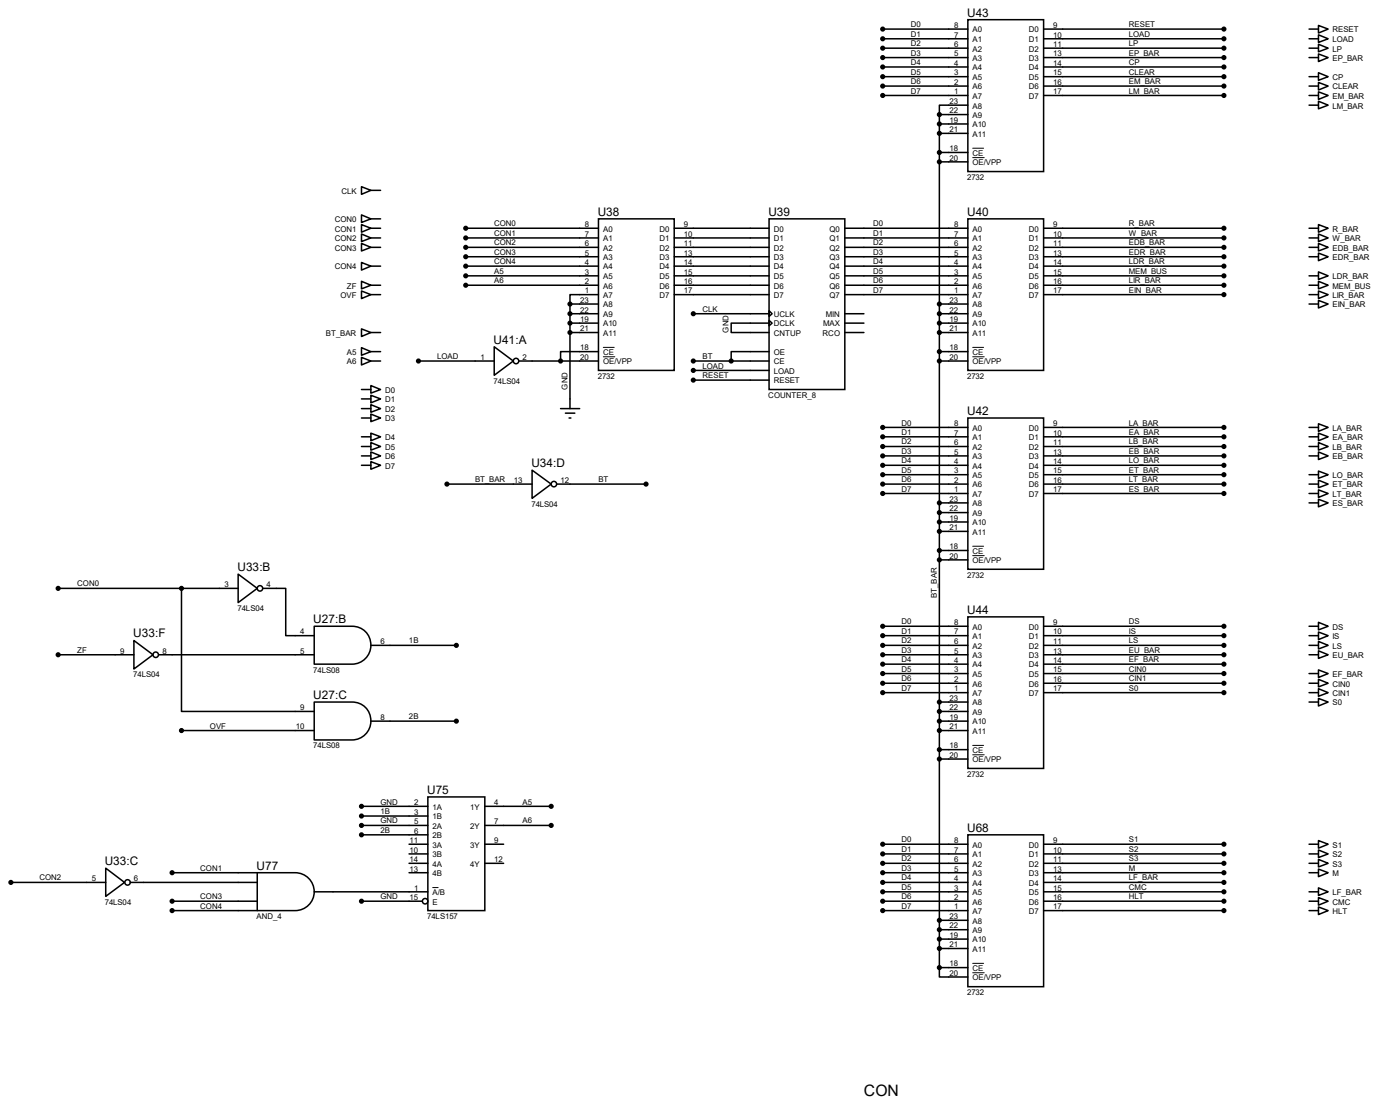
[picture p21: page 13]

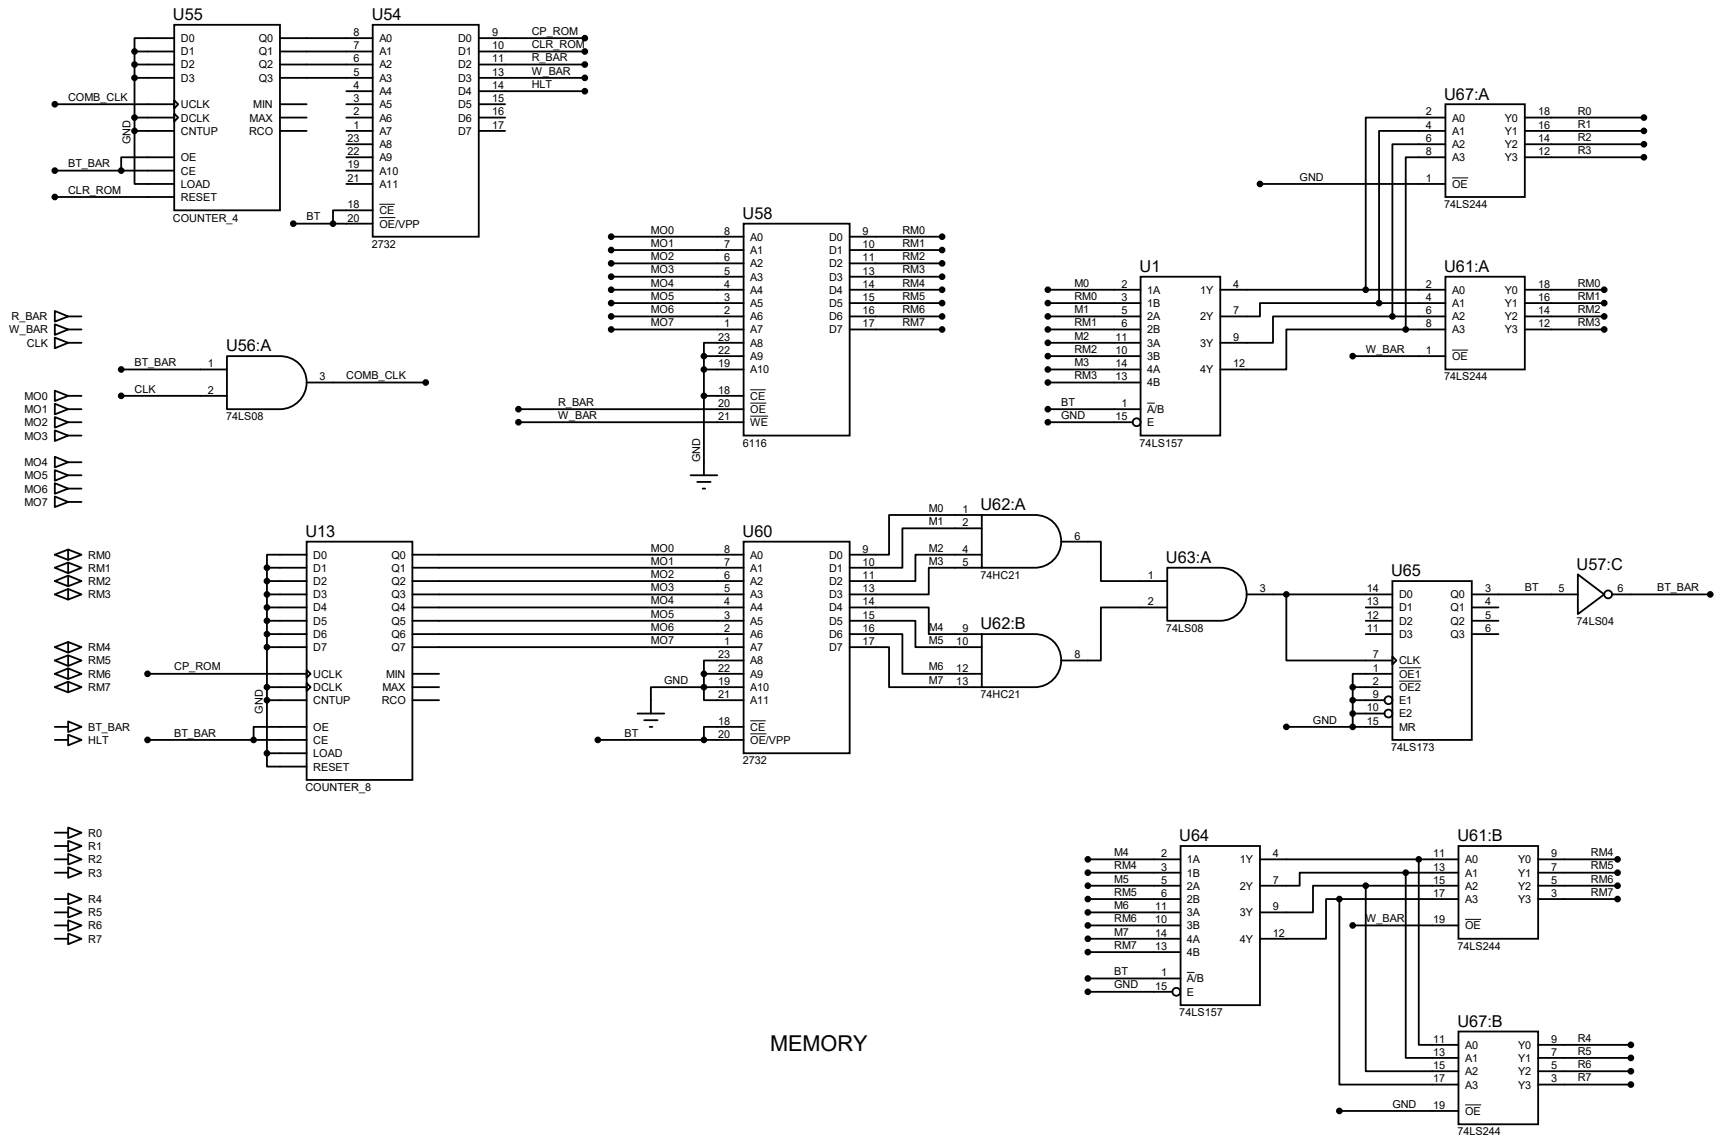
[picture p22: page 14]
