sakshar/4-bit_PC/(list of files, drawings)

Other design files:
uni_register.DSN
